asturnando/generador/assets/img/cap4-bobinado-manual-referencia-generada.webp

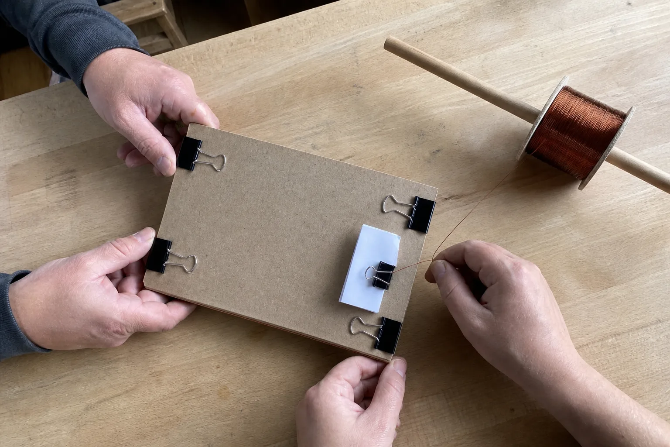
assets/img/cap4-bobinado-manual-referencia-generada.webp
