asturnando/generador/assets/img/cap4-bobina-manual-aceptable-referencia-generada.webp

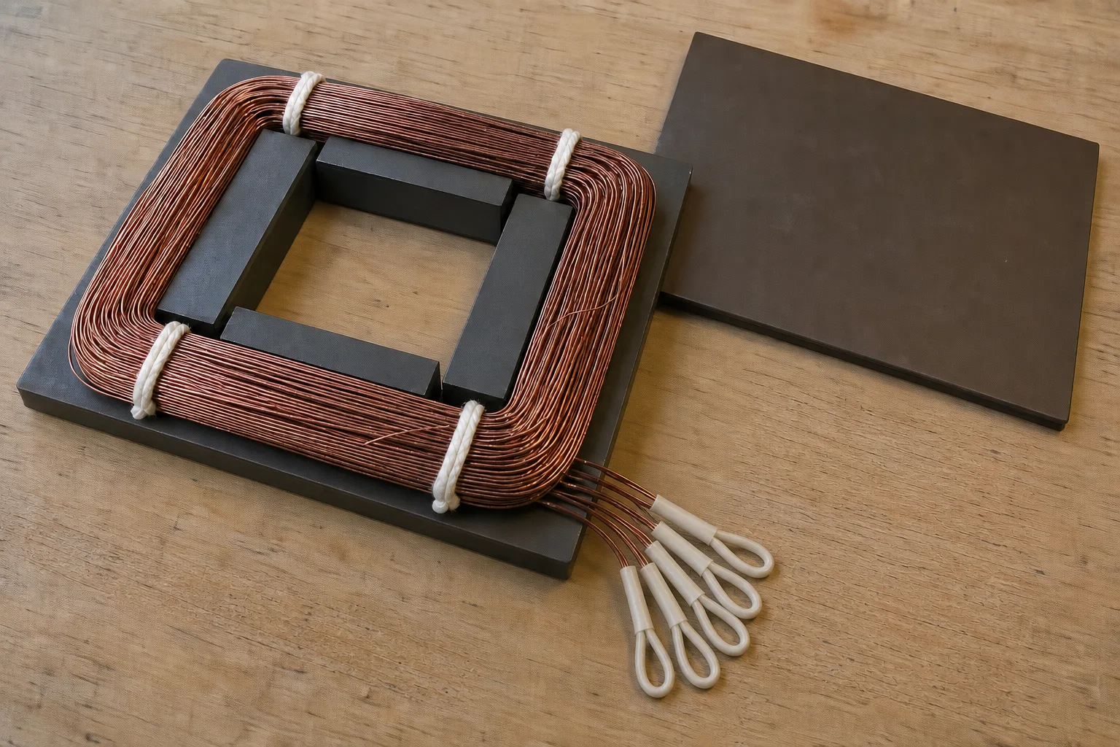
assets/img/cap4-bobina-manual-aceptable-referencia-generada.webp
