asturnando/generador/assets/img/adaptador-eje-motor.webp

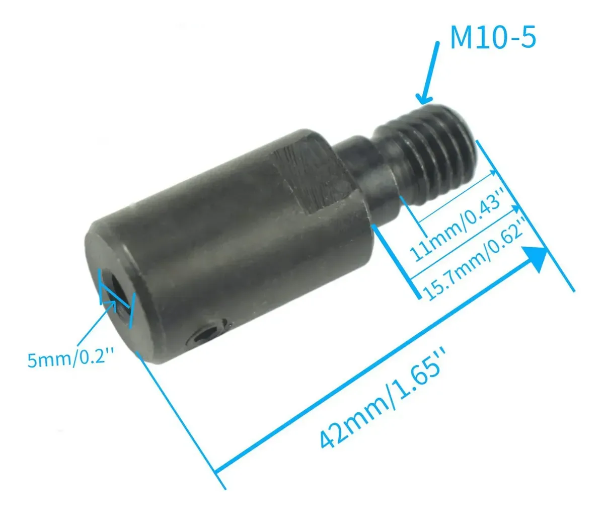
assets/img/adaptador-eje-motor.webp
