asturnando/generador/assets/img/alargador-con-tierra.webp

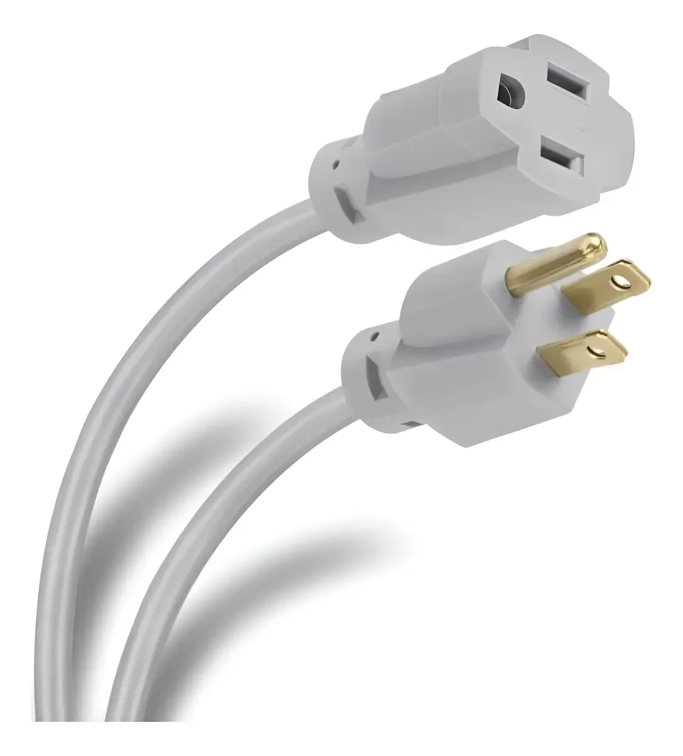
assets/img/alargador-con-tierra.webp
