asturnando/generador/assets/img/cable-awg18.webp

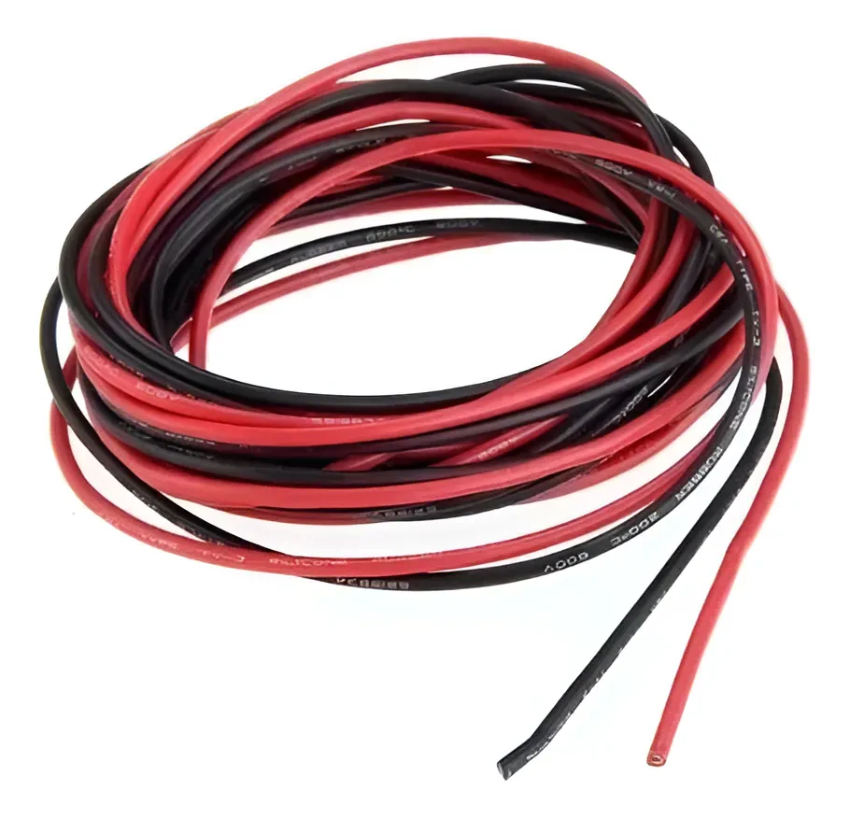
assets/img/cable-awg18.webp
