asturnando/generador/assets/img/cables-dupont-referencia-generada.webp

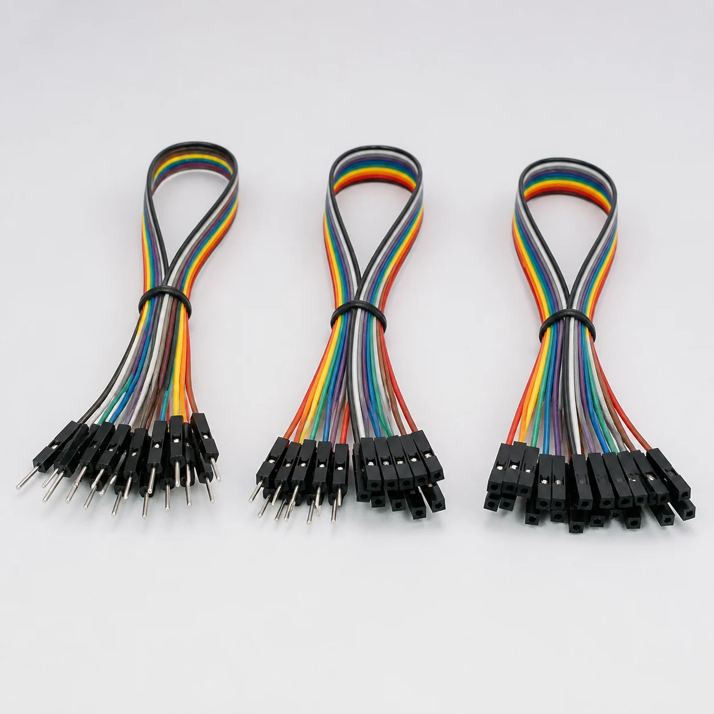
assets/img/cables-dupont-referencia-generada.webp
