asturnando/generador/assets/img/cap1-conductores-sin-pelar-referencia-generada.webp

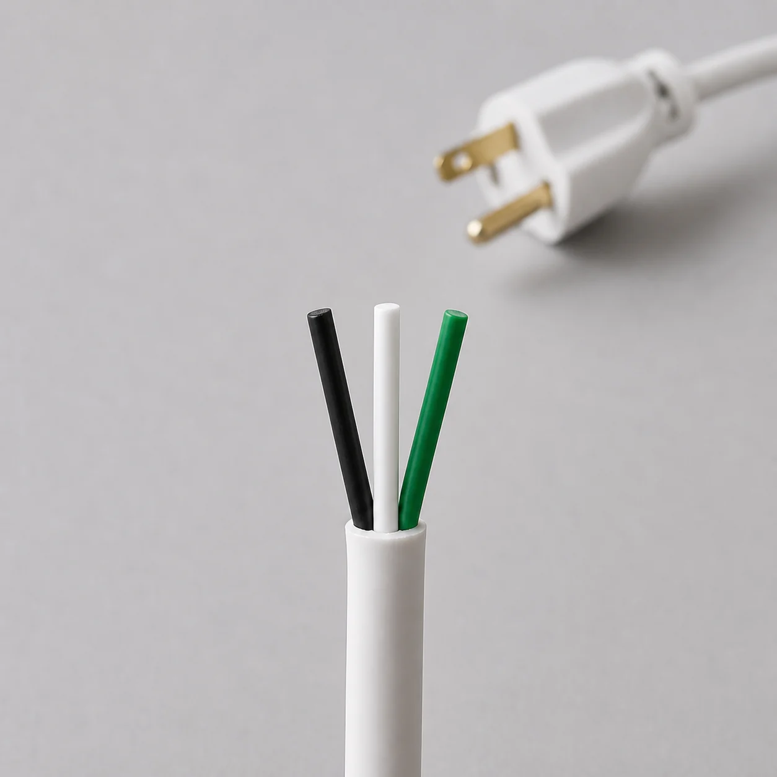
assets/img/cap1-conductores-sin-pelar-referencia-generada.webp
