asturnando/generador/assets/img/cap1-mesa-trabajo-referencia-generada.webp

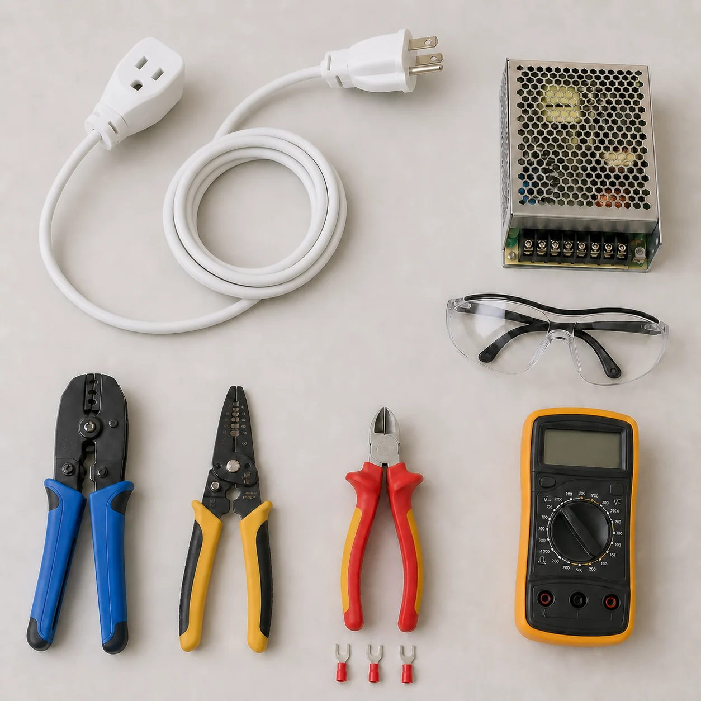
assets/img/cap1-mesa-trabajo-referencia-generada.webp
