asturnando/generador/assets/img/cap1-proteccion-fuente-referencia-generada.webp

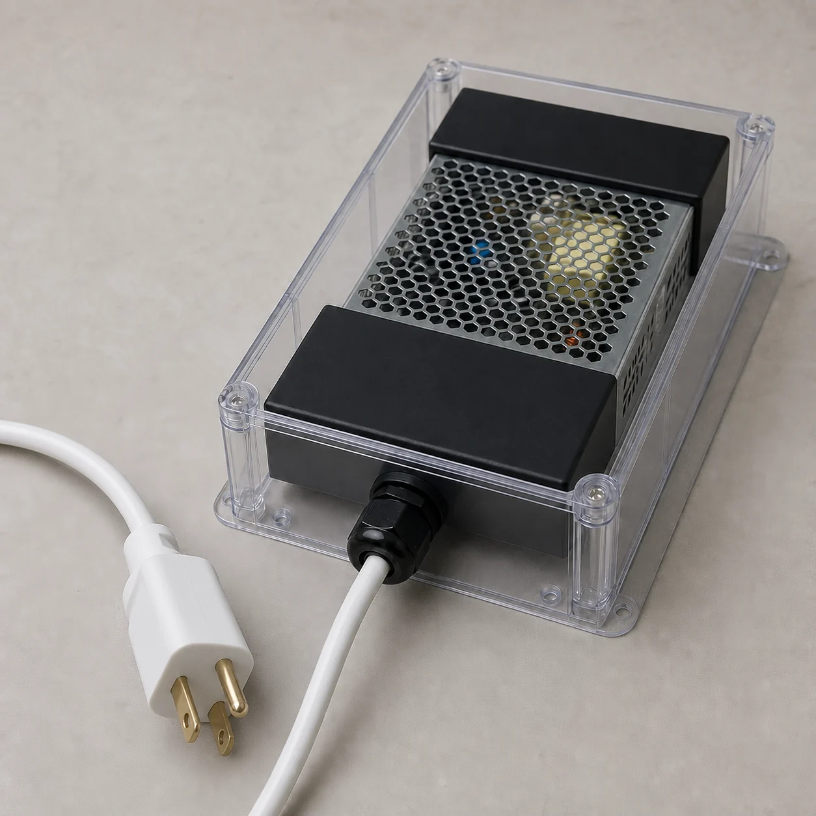
assets/img/cap1-proteccion-fuente-referencia-generada.webp
