asturnando/generador/assets/img/cap1-terminales-crimpados-referencia-generada.webp

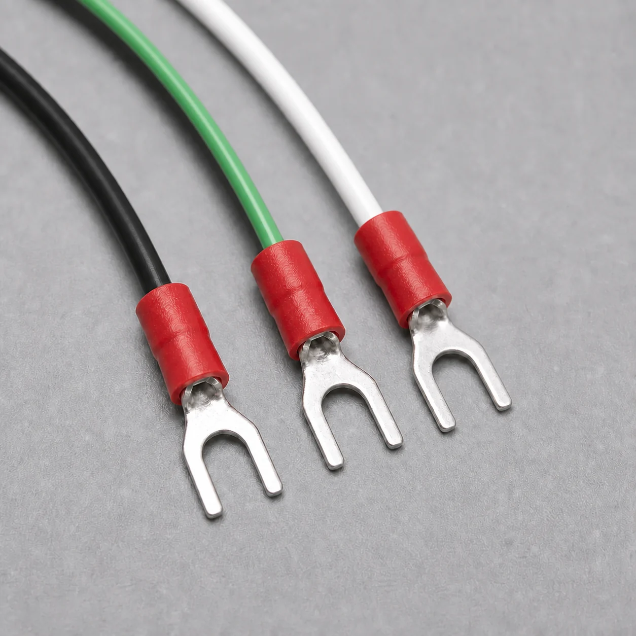
assets/img/cap1-terminales-crimpados-referencia-generada.webp
