asturnando/generador/assets/img/cap2-banco-sin-cablear-referencia-generada.webp

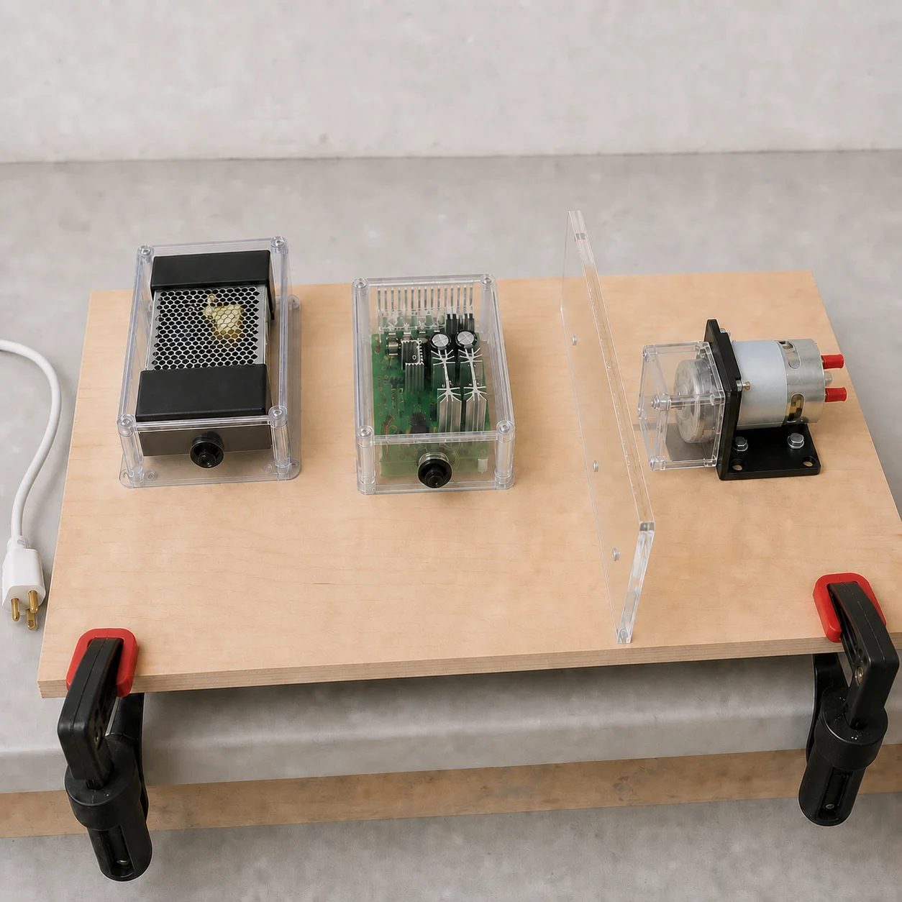
assets/img/cap2-banco-sin-cablear-referencia-generada.webp
