asturnando/generador/assets/img/cap2-motor-sujeto-referencia-generada.webp

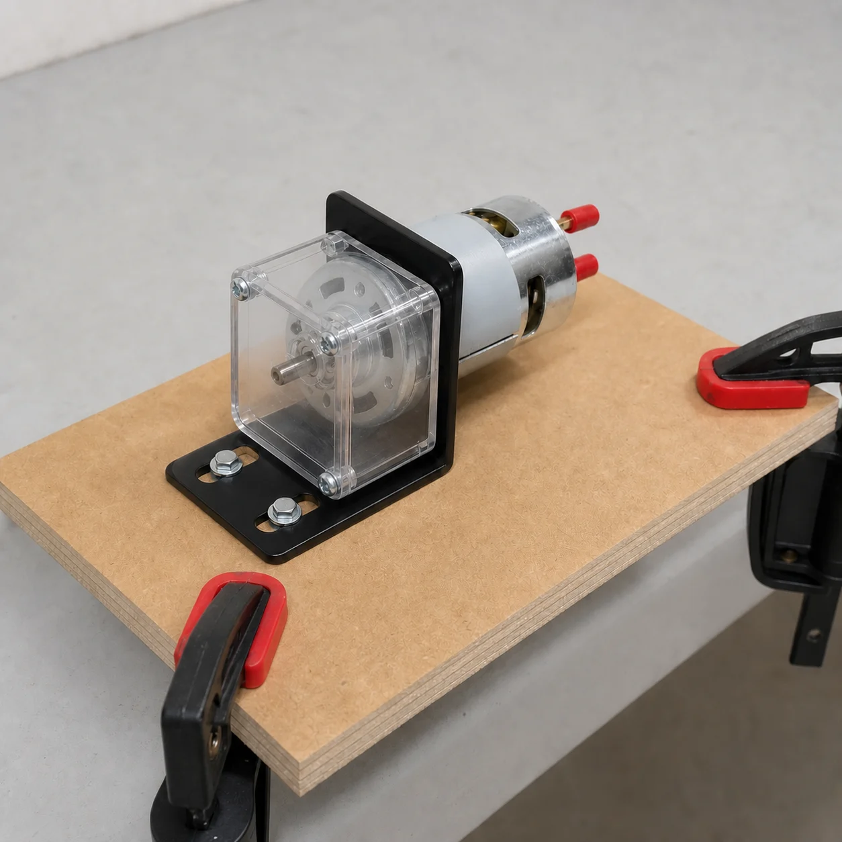
assets/img/cap2-motor-sujeto-referencia-generada.webp
