asturnando/generador/assets/img/cap2-pwm-protegido-referencia-generada.webp

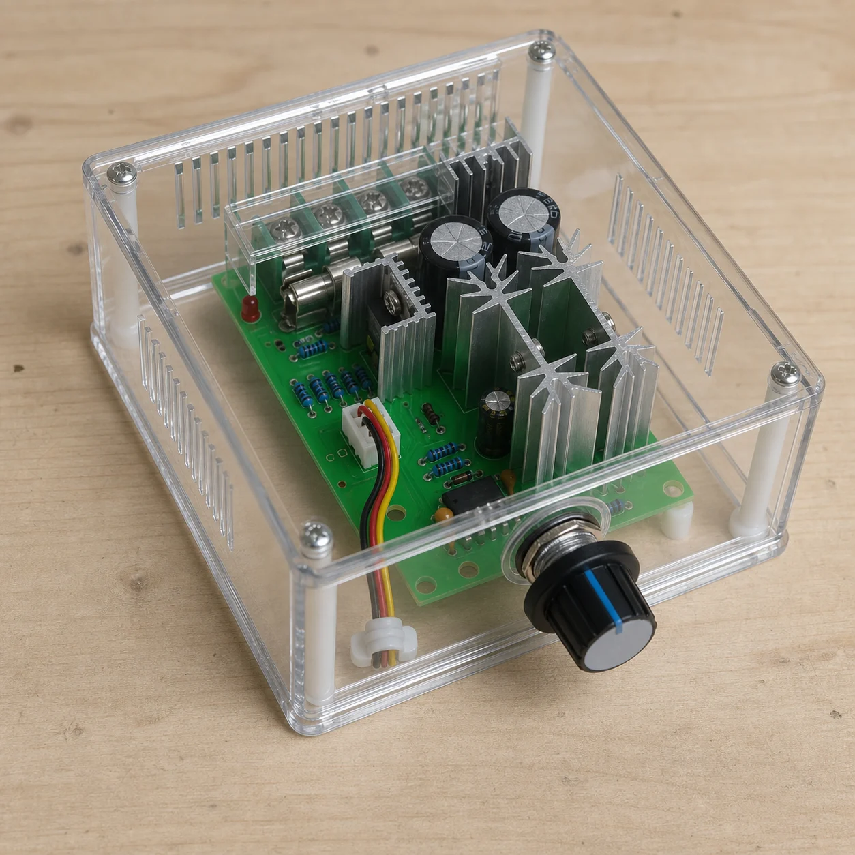
assets/img/cap2-pwm-protegido-referencia-generada.webp
