asturnando/generador/assets/img/cap3-clasificacion-imanes-referencia-generada.webp

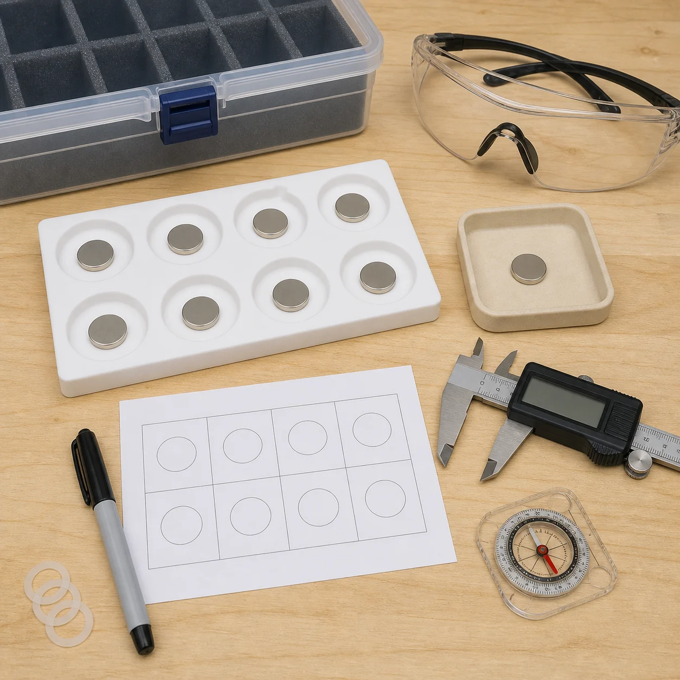
assets/img/cap3-clasificacion-imanes-referencia-generada.webp
