asturnando/generador/assets/img/cap3-medicion-adaptador-referencia-generada.webp

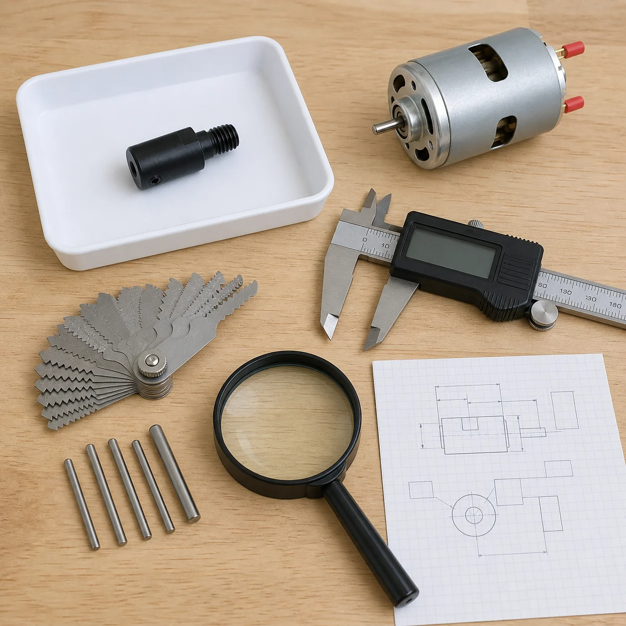
assets/img/cap3-medicion-adaptador-referencia-generada.webp
