asturnando/generador/assets/img/cap4-bobina-final-referencia-generada.webp

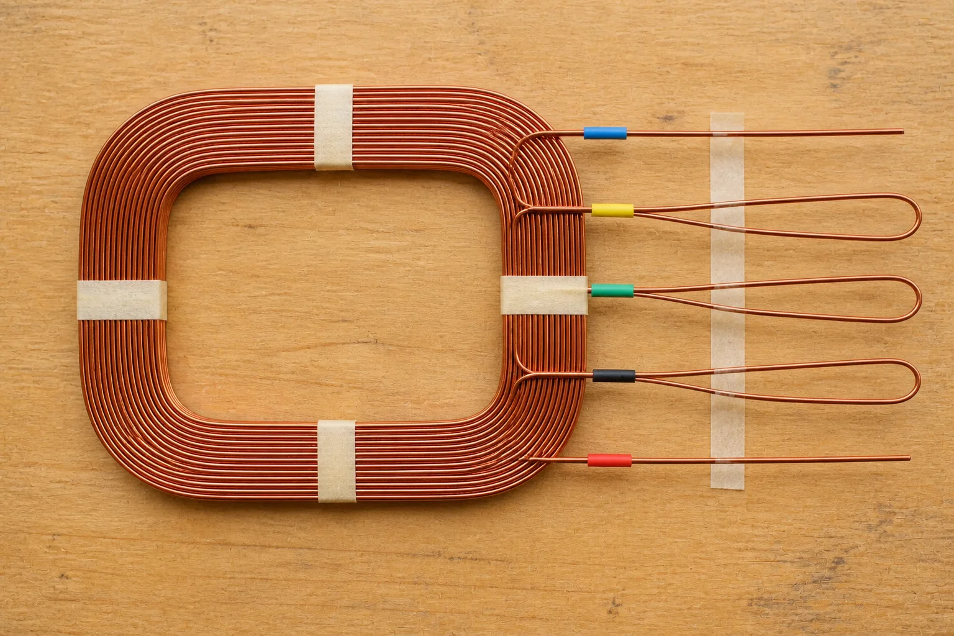
assets/img/cap4-bobina-final-referencia-generada.webp
