asturnando/generador/assets/img/cap4-derivacion-u-referencia-generada.webp

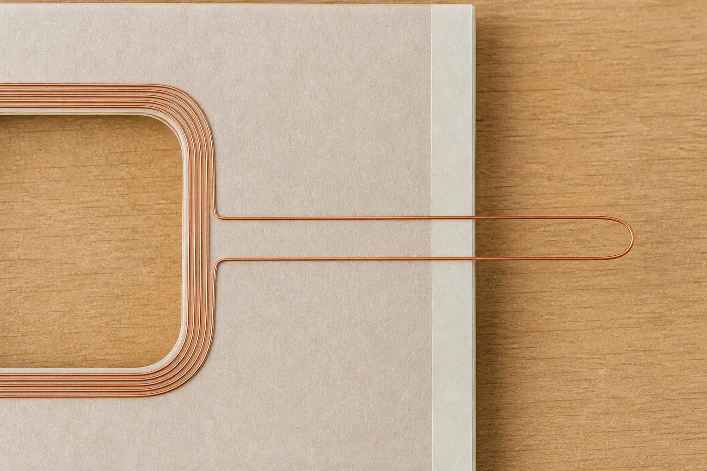
assets/img/cap4-derivacion-u-referencia-generada.webp
