asturnando/generador/assets/img/cap4-inicio-bobinado-referencia-generada.webp

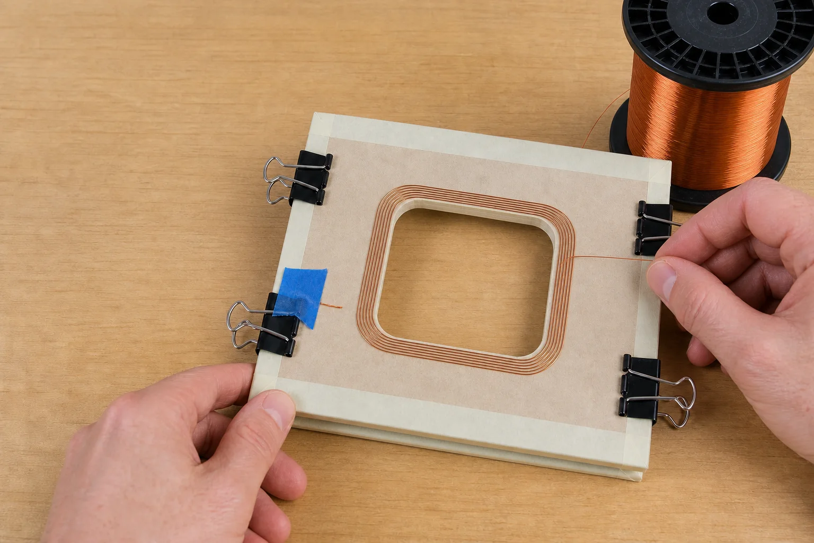
assets/img/cap4-inicio-bobinado-referencia-generada.webp
