asturnando/generador/assets/img/cap4-multimetro-continuidad-referencia-generada.webp

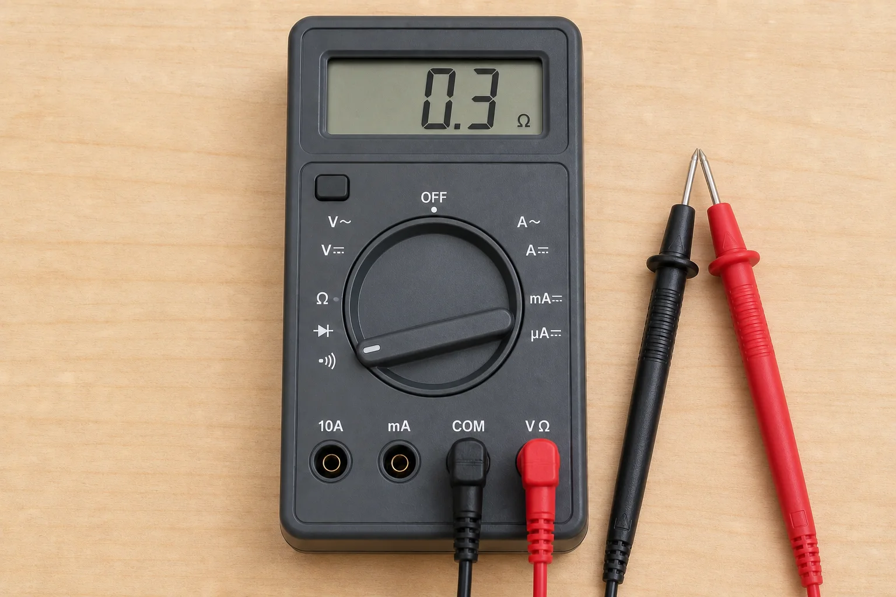
assets/img/cap4-multimetro-continuidad-referencia-generada.webp
