asturnando/generador/assets/img/cap4-multimetro-puntas-referencia-generada.webp

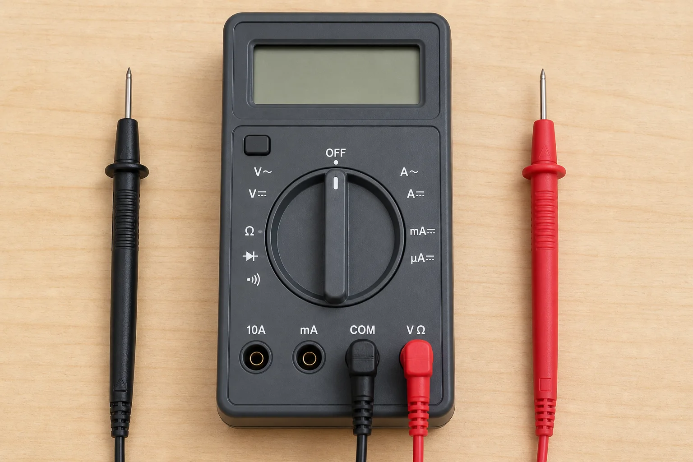
assets/img/cap4-multimetro-puntas-referencia-generada.webp
