asturnando/generador/assets/img/cap4-multimetro-resistencia-referencia-generada.webp

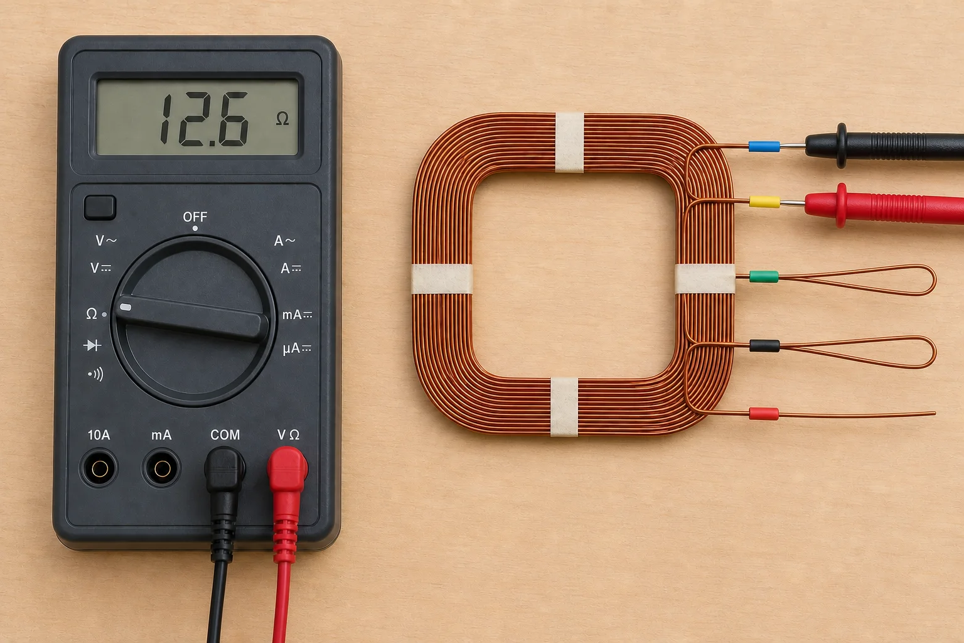
assets/img/cap4-multimetro-resistencia-referencia-generada.webp
