asturnando/generador/assets/img/cap4-multimetro-tension-ac-referencia-generada.webp

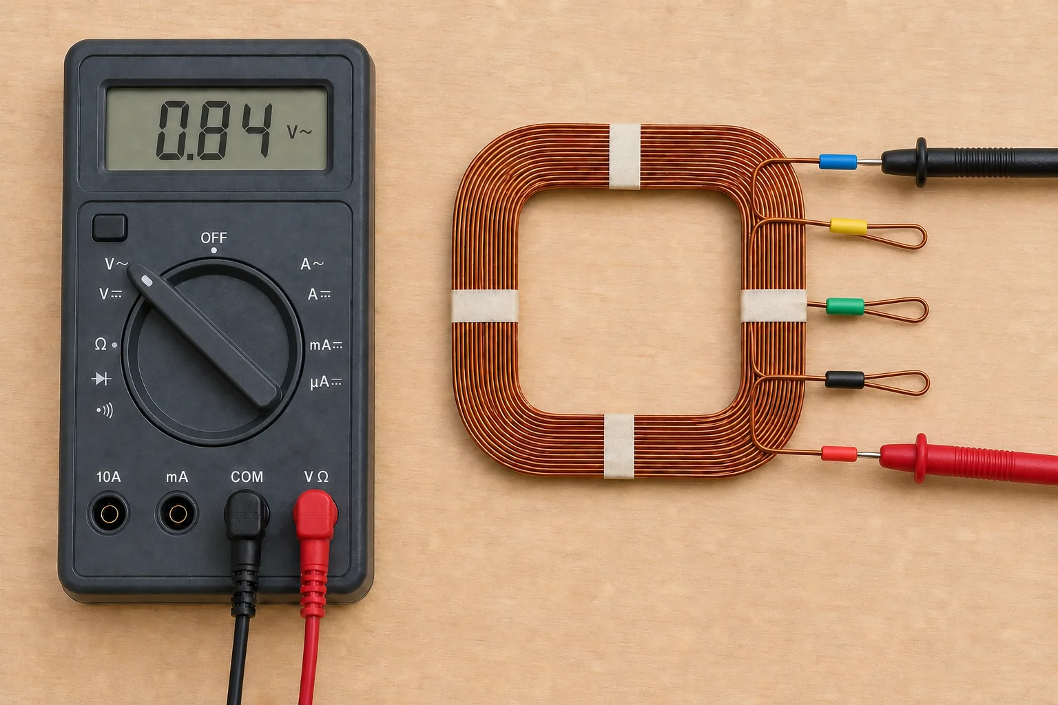
assets/img/cap4-multimetro-tension-ac-referencia-generada.webp
