asturnando/generador/assets/img/cap4-soporte-bobina-ajustable-referencia-generada.webp

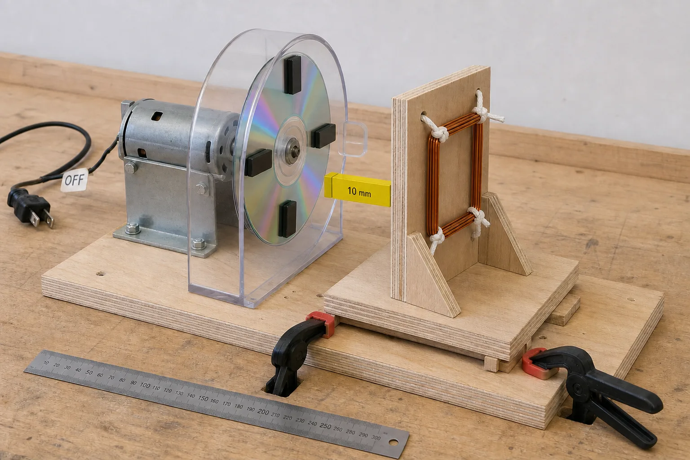
assets/img/cap4-soporte-bobina-ajustable-referencia-generada.webp
