asturnando/generador/assets/img/cap4-util-bobinado-referencia-generada.webp

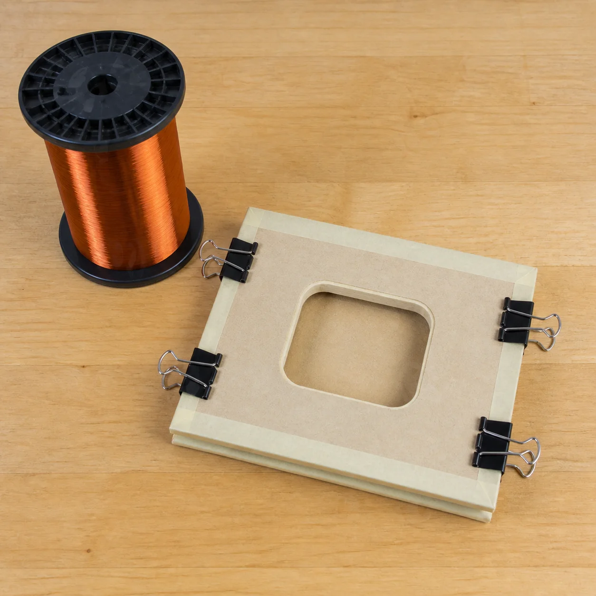
assets/img/cap4-util-bobinado-referencia-generada.webp
