asturnando/generador/assets/img/cap4-util-cerrado-referencia-generada.webp

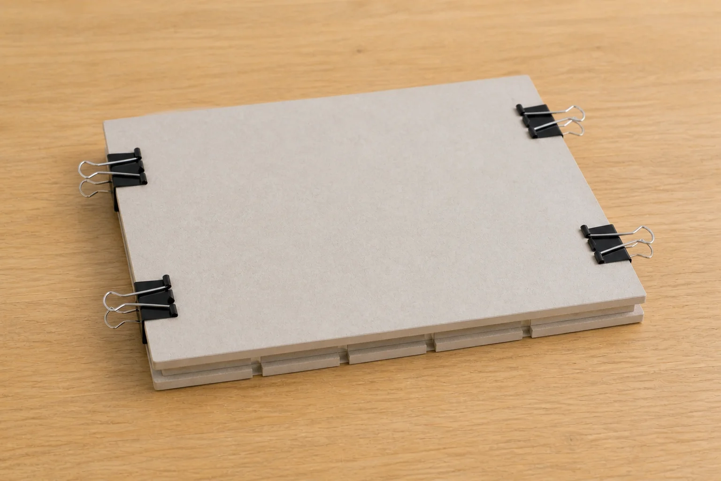
assets/img/cap4-util-cerrado-referencia-generada.webp
