asturnando/generador/assets/img/cap4-util-extraccion-referencia-generada.webp

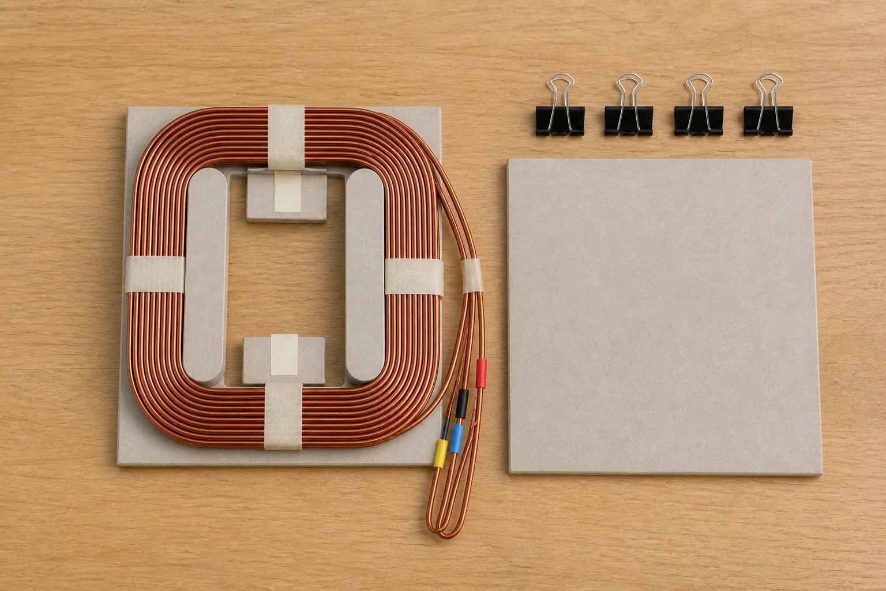
assets/img/cap4-util-extraccion-referencia-generada.webp
