asturnando/generador/assets/img/cap4-util-nucleo-referencia-generada.webp

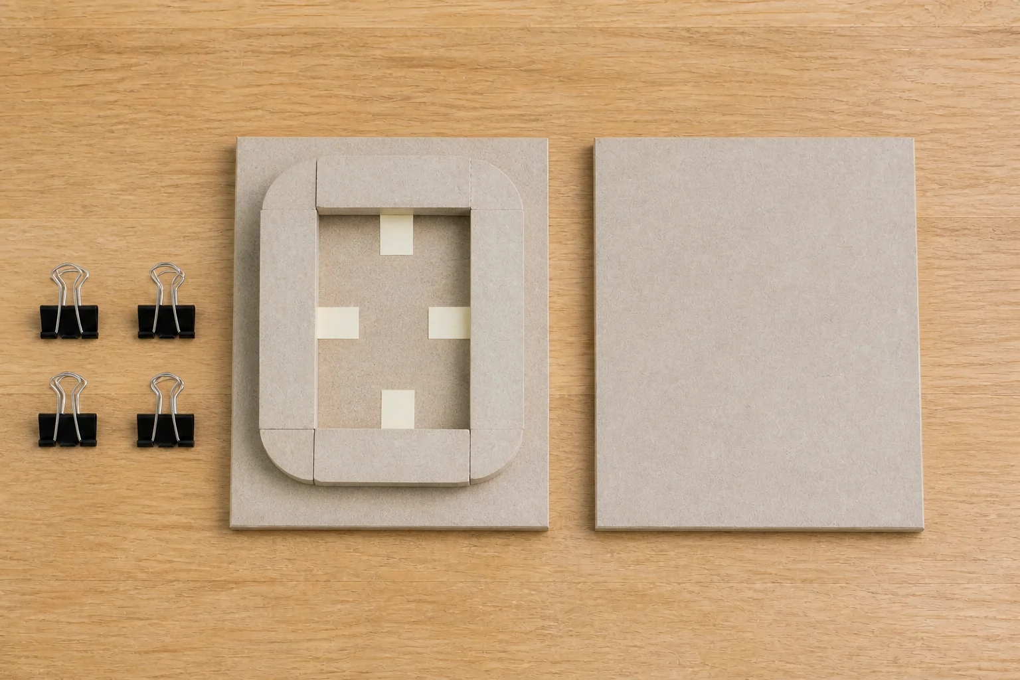
assets/img/cap4-util-nucleo-referencia-generada.webp
