asturnando/generador/assets/img/cap4-util-piezas-referencia-generada.webp

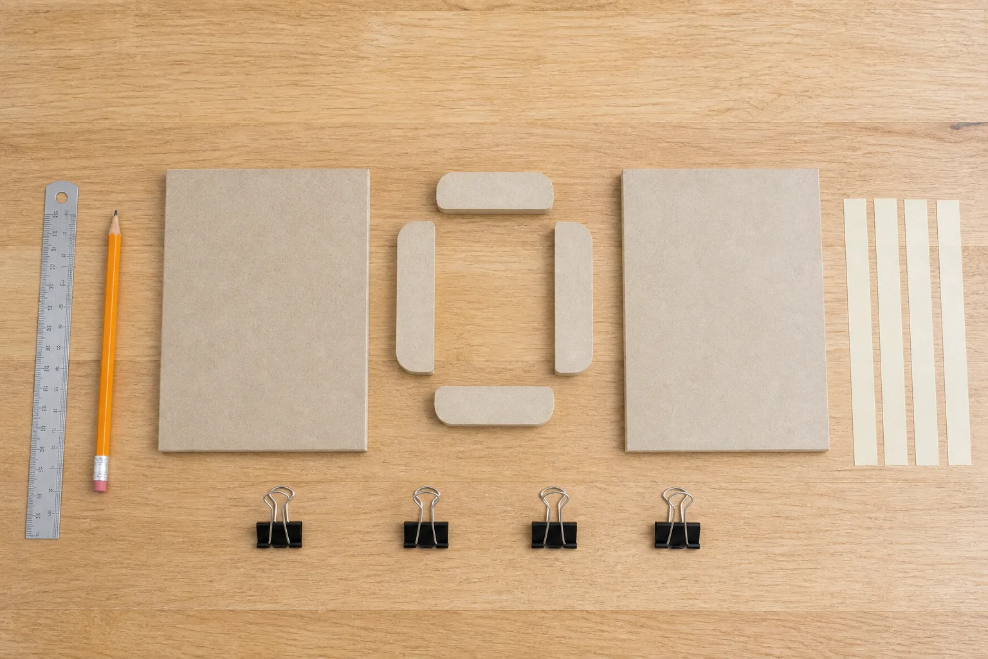
assets/img/cap4-util-piezas-referencia-generada.webp
