asturnando/generador/assets/img/cobre-esmaltado-awg28.webp

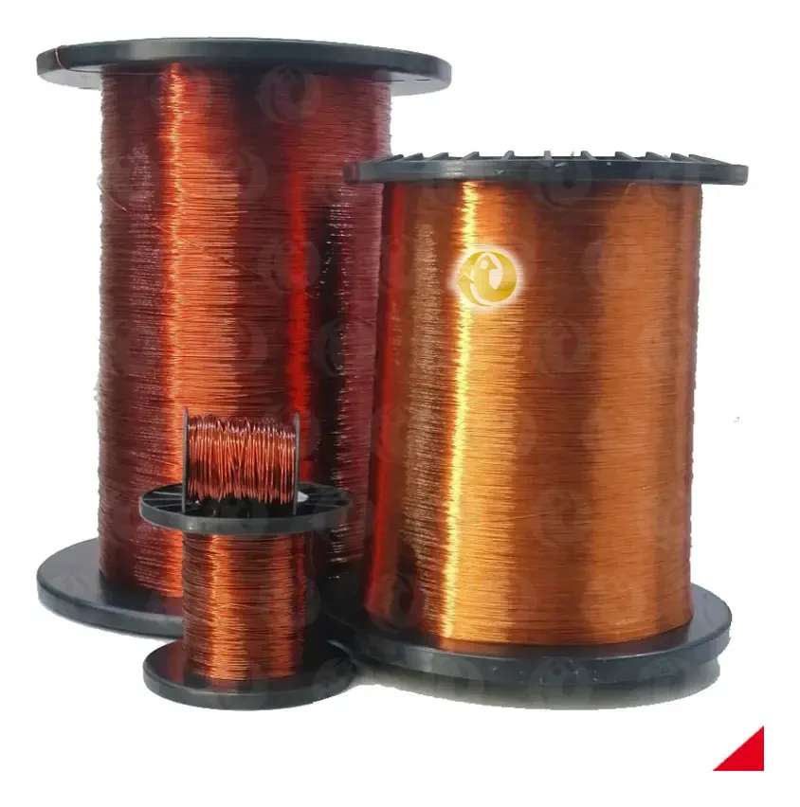
assets/img/cobre-esmaltado-awg28.webp
