asturnando/generador/assets/img/diodos-1n5818.webp

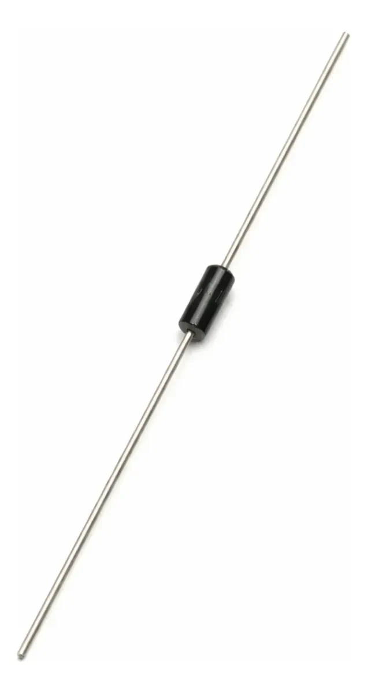
assets/img/diodos-1n5818.webp
