asturnando/generador/assets/img/disco-incluido-no-usar.webp

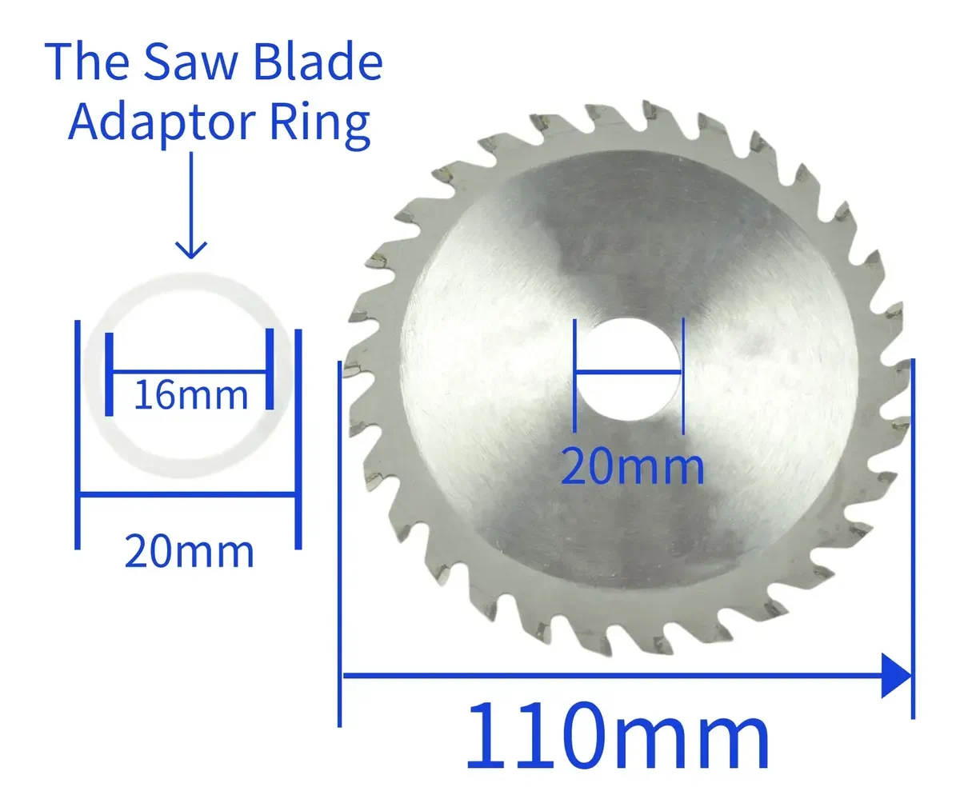
assets/img/disco-incluido-no-usar.webp
