asturnando/generador/assets/img/esp32-s3-devkitc-1-oficial.webp

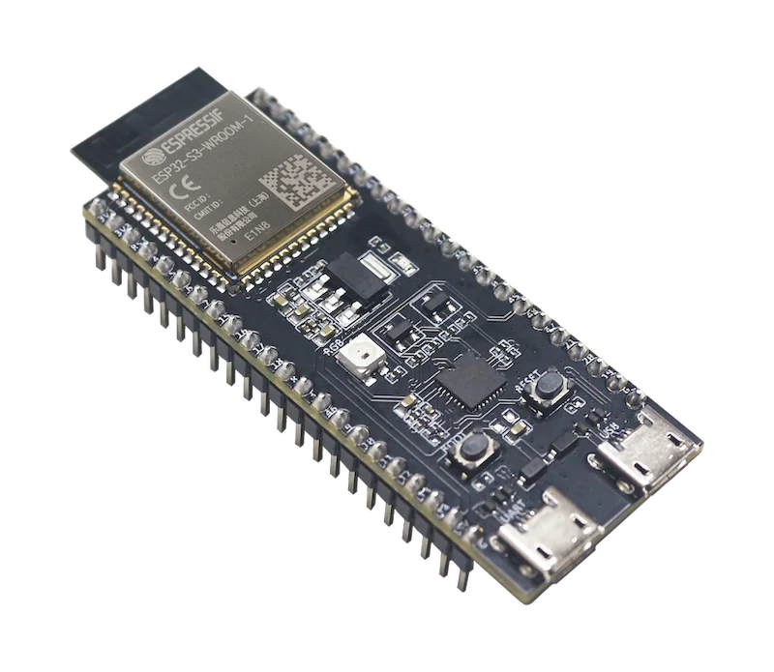
assets/img/esp32-s3-devkitc-1-oficial.webp
