asturnando/generador/assets/img/fuente-12v-10a-vista.webp

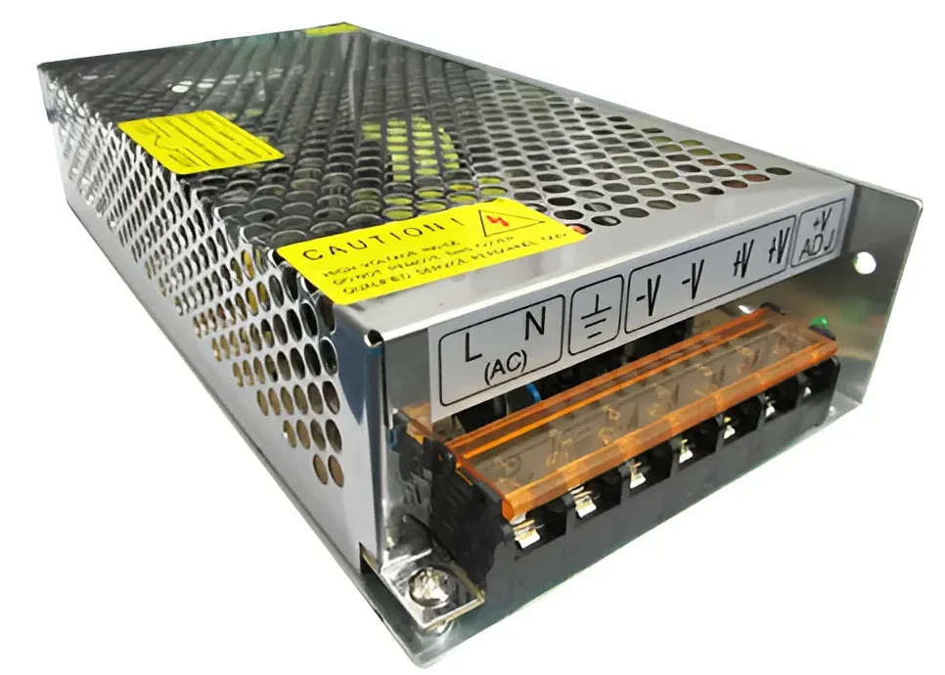
assets/img/fuente-12v-10a-vista.webp
