asturnando/generador/assets/img/fuente-12v-10a.webp

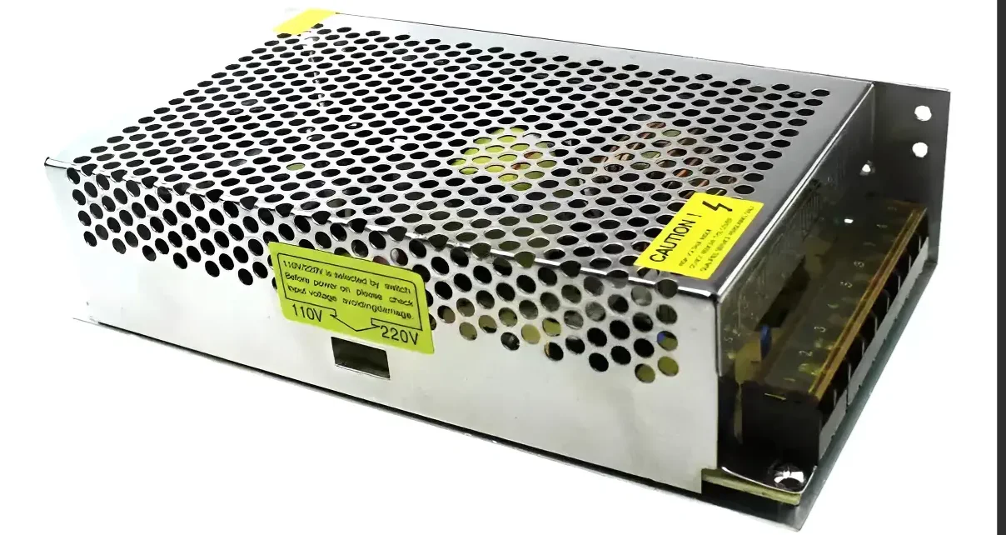
assets/img/fuente-12v-10a.webp
