asturnando/generador/assets/img/fuente-bornes.webp

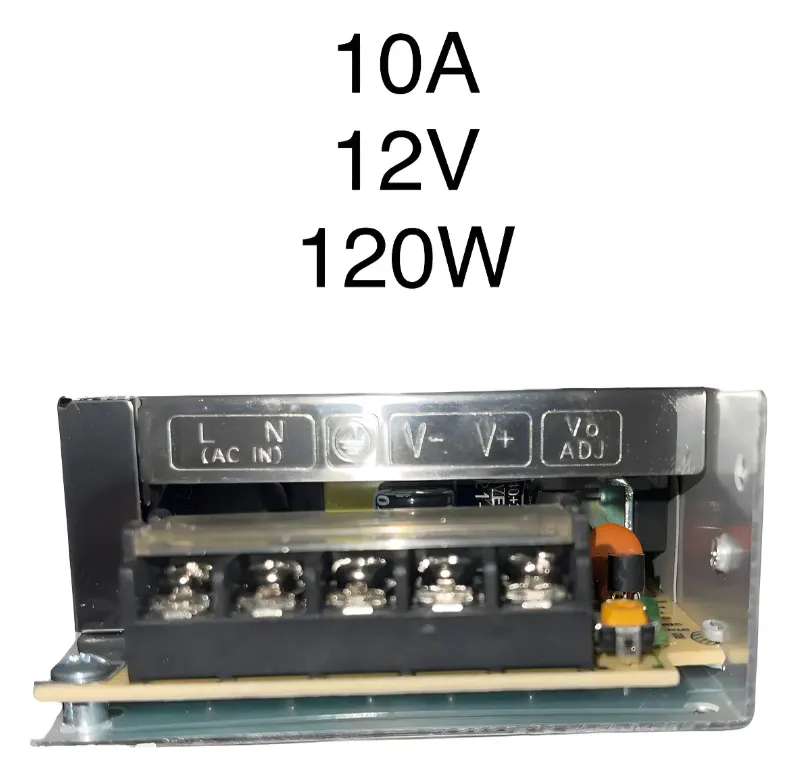
assets/img/fuente-bornes.webp
