asturnando/generador/assets/img/fuente-selector-tension.webp

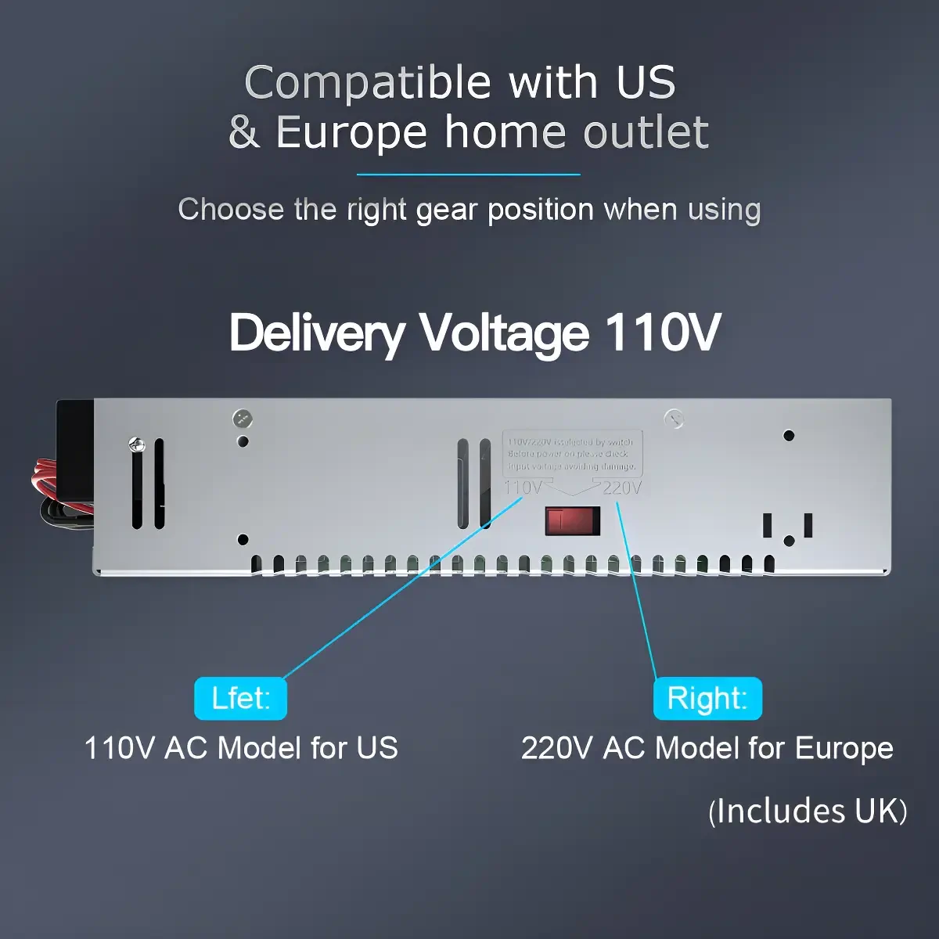
assets/img/fuente-selector-tension.webp
