asturnando/generador/assets/img/imanes-rectangulares.webp

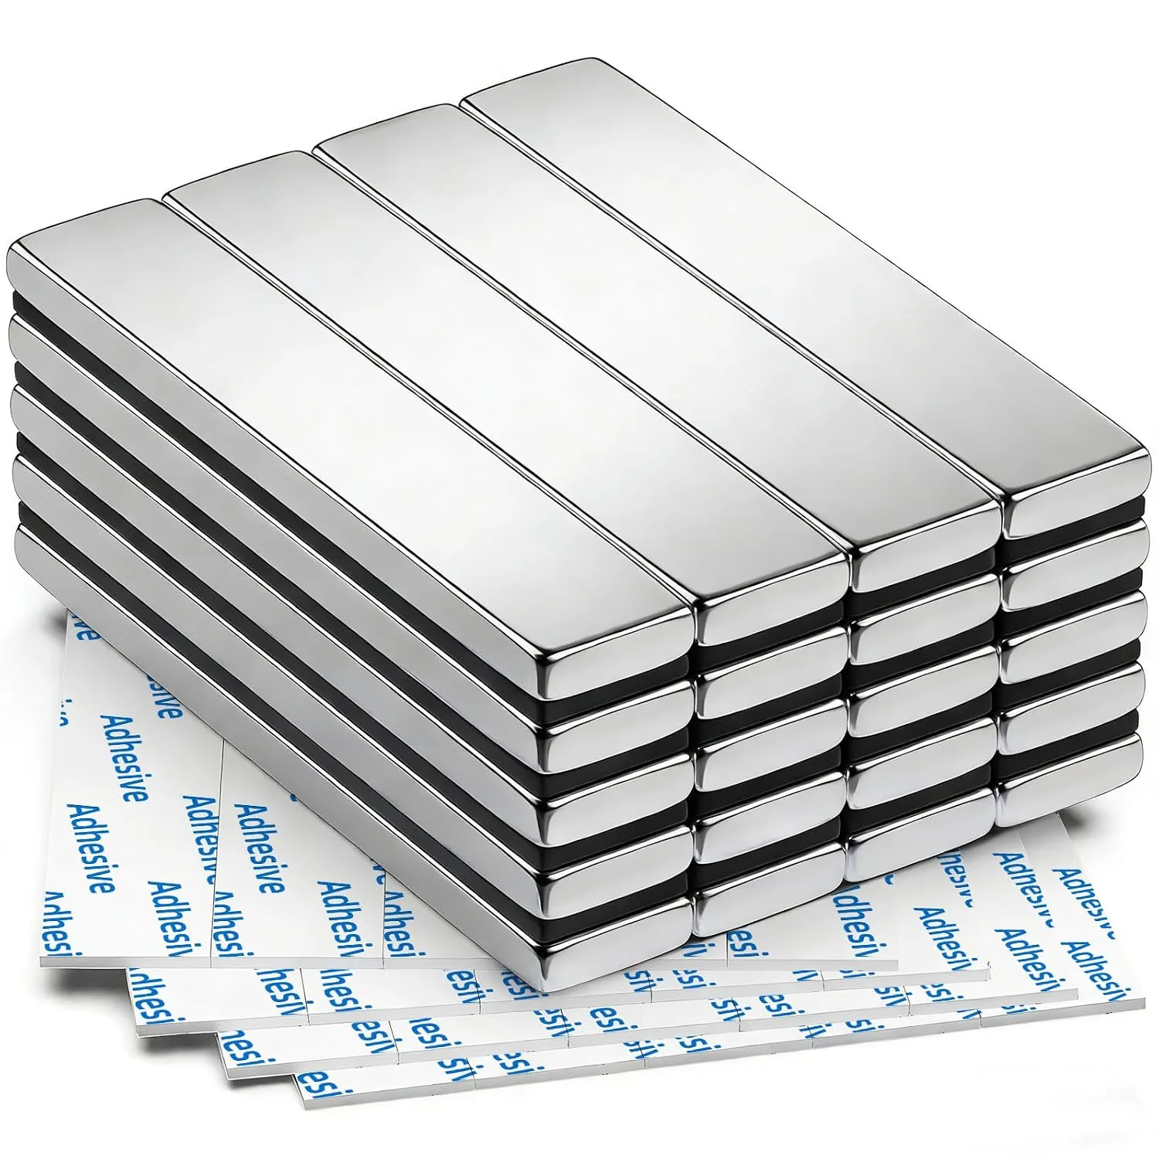
assets/img/imanes-rectangulares.webp
