asturnando/generador/assets/img/imanes-redondos-referencia-generada.webp

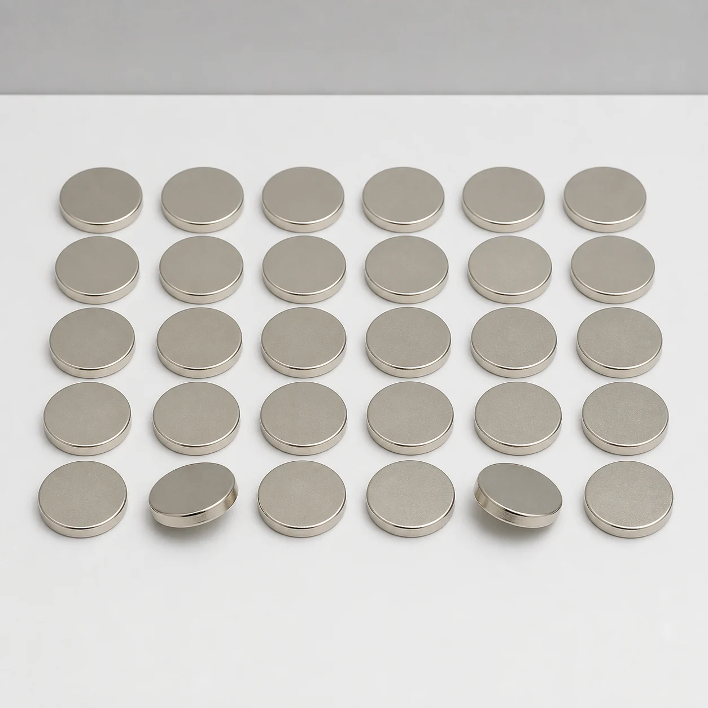
assets/img/imanes-redondos-referencia-generada.webp
