asturnando/generador/assets/img/ina219.webp

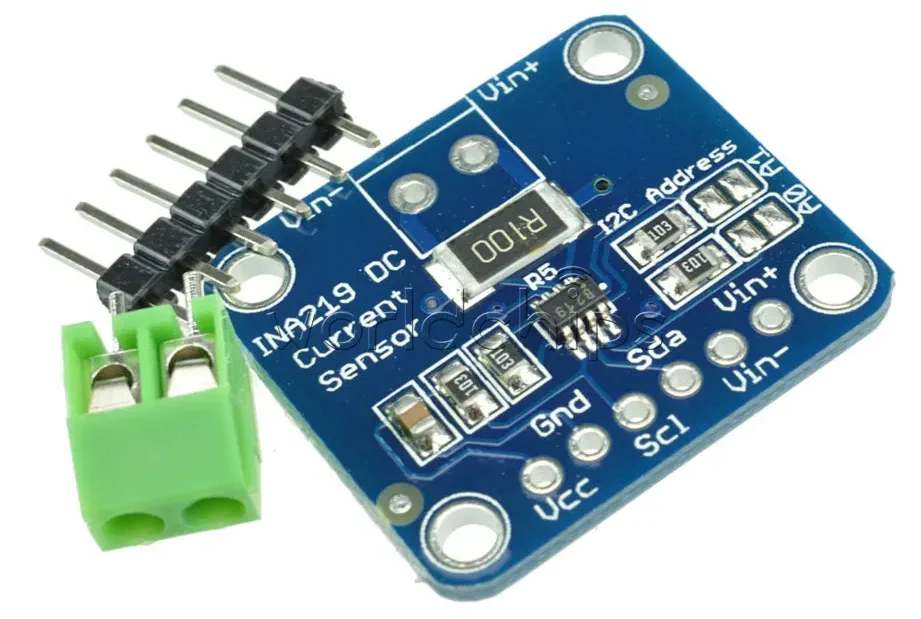
assets/img/ina219.webp
