asturnando/generador/assets/img/kit-resistencias-referencia-generada.webp

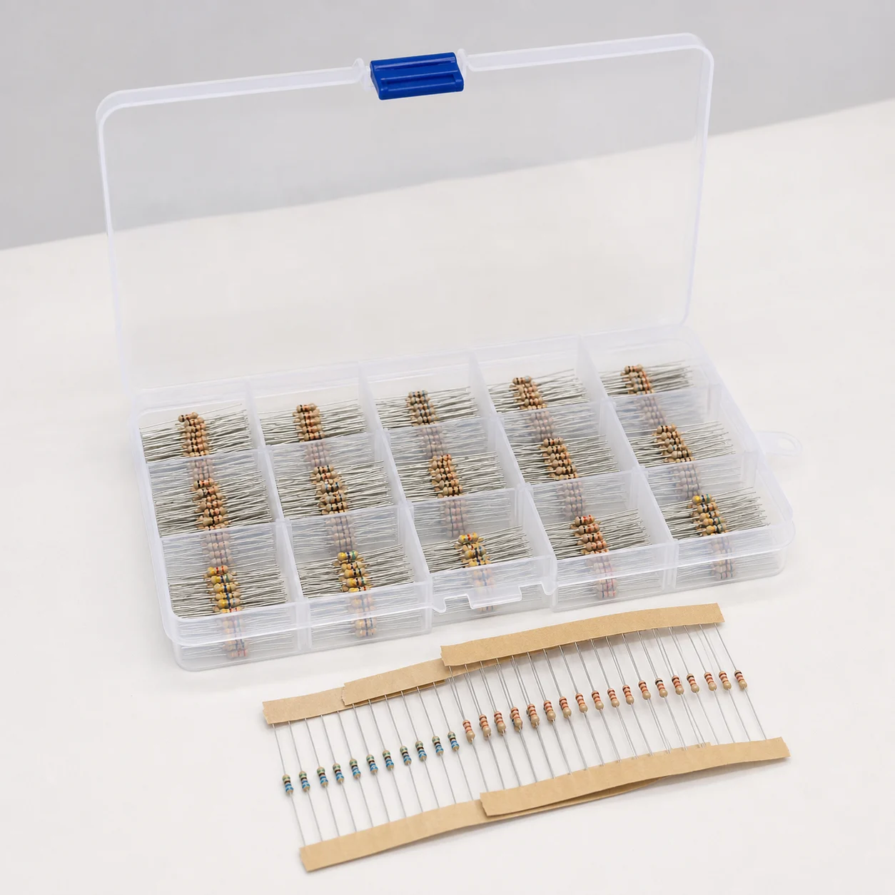
assets/img/kit-resistencias-referencia-generada.webp
