asturnando/generador/assets/img/ky003.webp

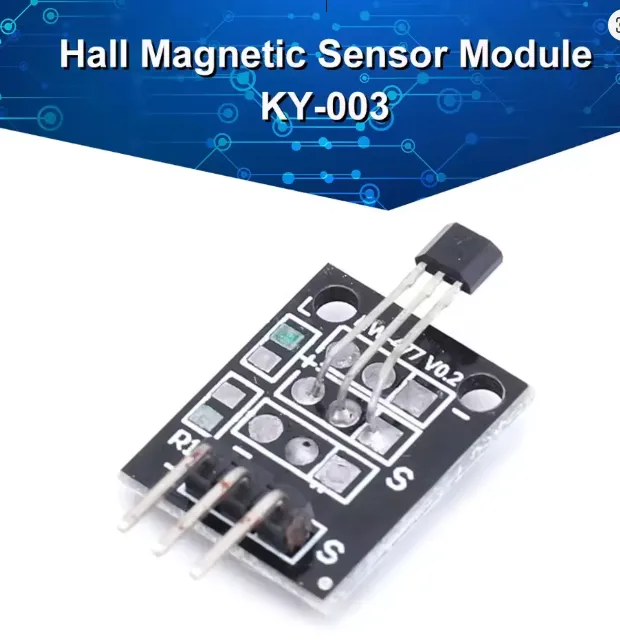
assets/img/ky003.webp
