asturnando/generador/assets/img/leds-referencia-generada.webp

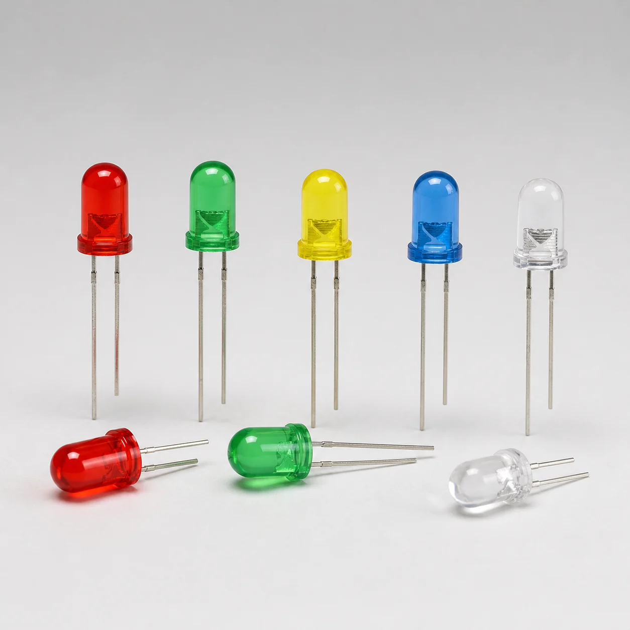
assets/img/leds-referencia-generada.webp
