asturnando/generador/assets/img/motor-775-kit.webp

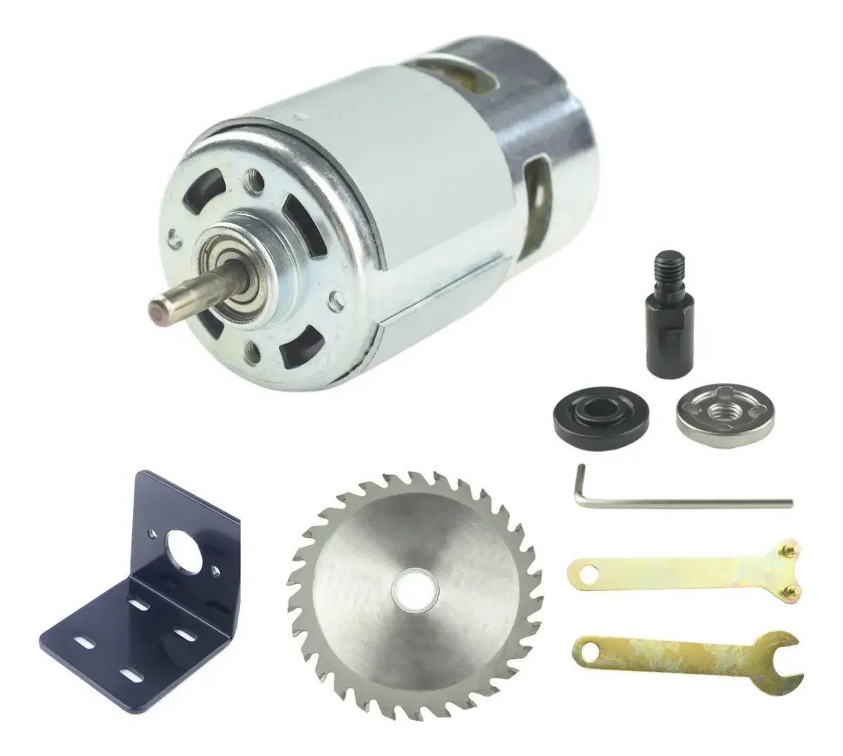
assets/img/motor-775-kit.webp
