asturnando/generador/assets/img/motor-775-medidas.webp

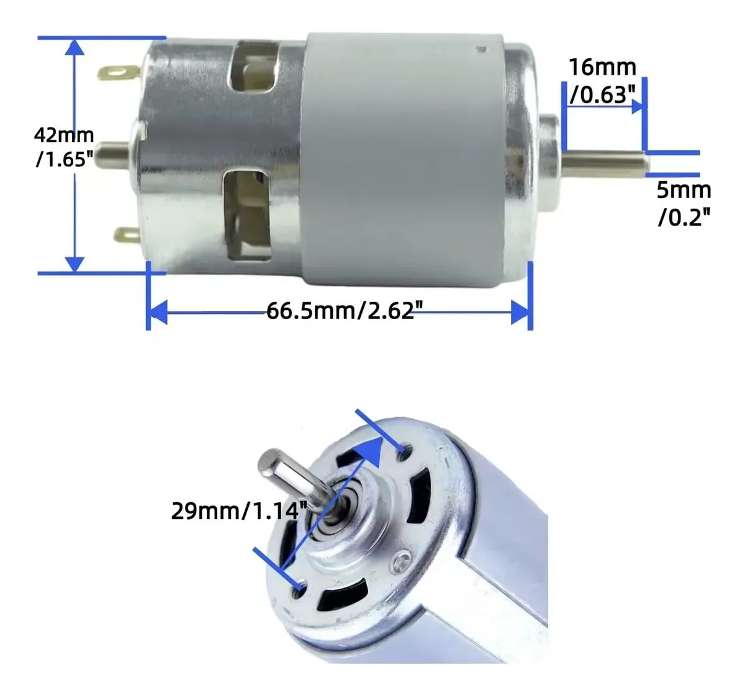
assets/img/motor-775-medidas.webp
