asturnando/generador/assets/img/protoboard.webp

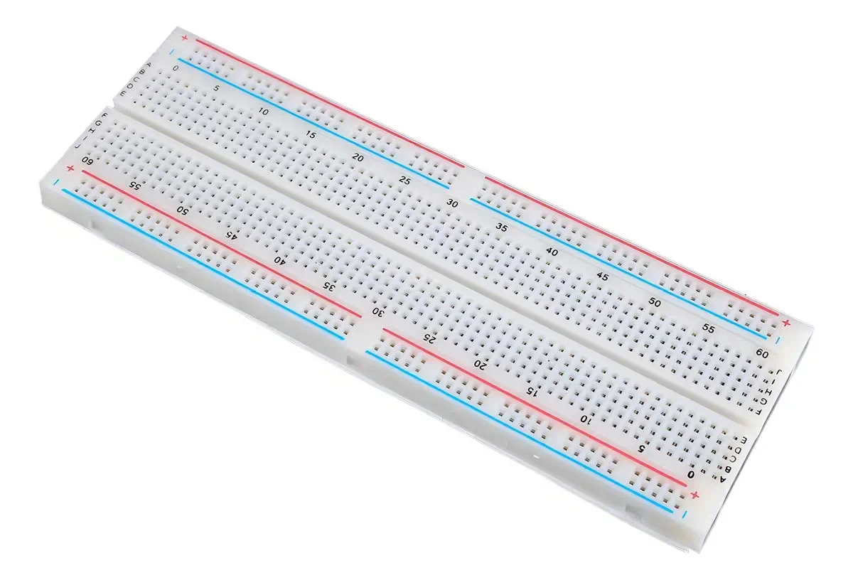
assets/img/protoboard.webp
