asturnando/generador/assets/img/pwm-vista.webp

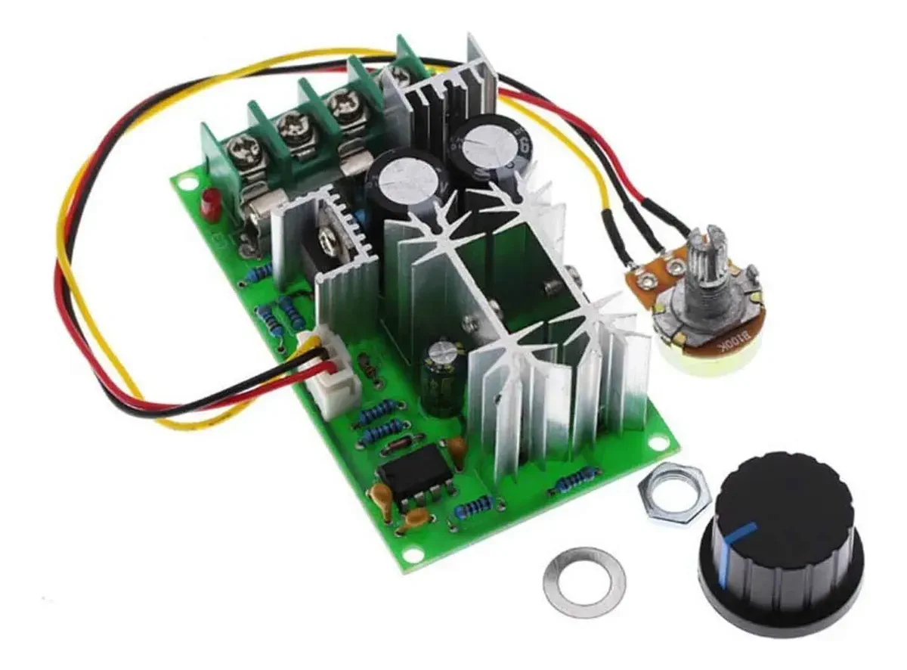
assets/img/pwm-vista.webp
