asturnando/generador/assets/img/pwm.webp

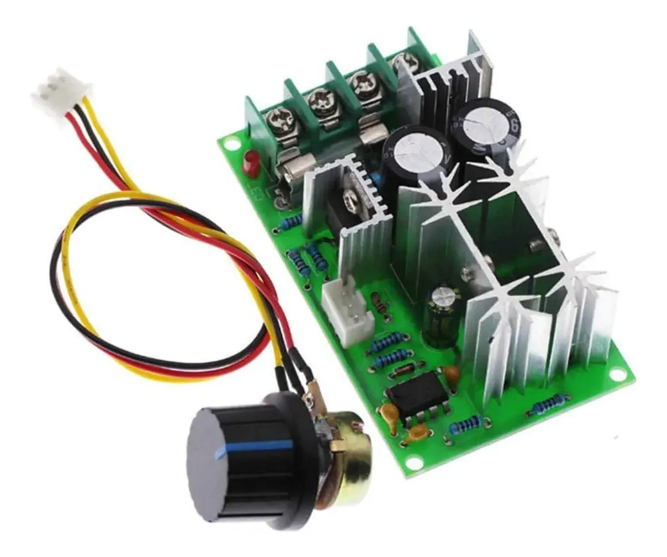
assets/img/pwm.webp
