asturnando/generador/assets/img/resistencia-100ohm-5w.webp

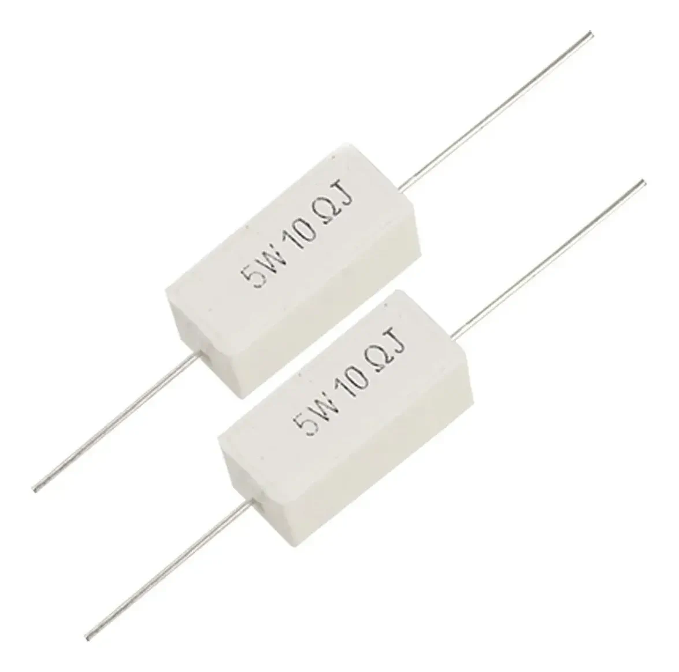
assets/img/resistencia-100ohm-5w.webp
