asturnando/generador/assets/img/soporte-motor-775.webp

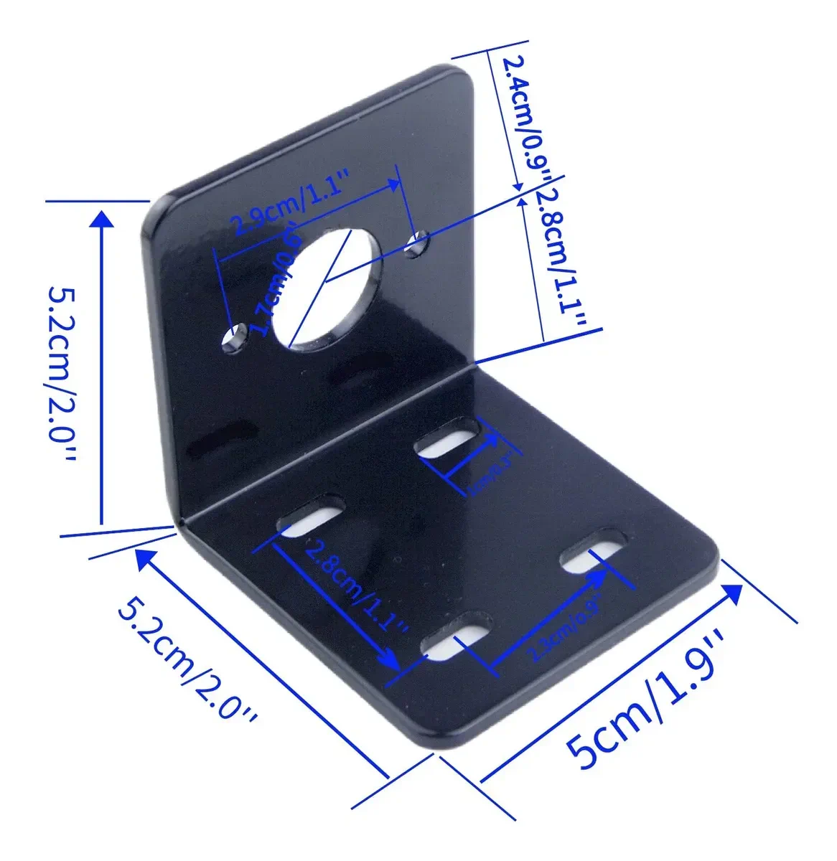
assets/img/soporte-motor-775.webp
