asturnando/generador/assets/img/tcrt5000.webp

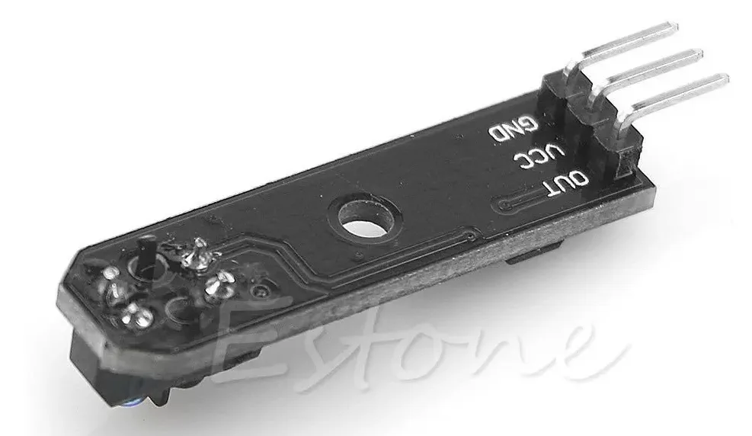
assets/img/tcrt5000.webp
