asturnando/generador/assets/img/terminales-horquilla.webp

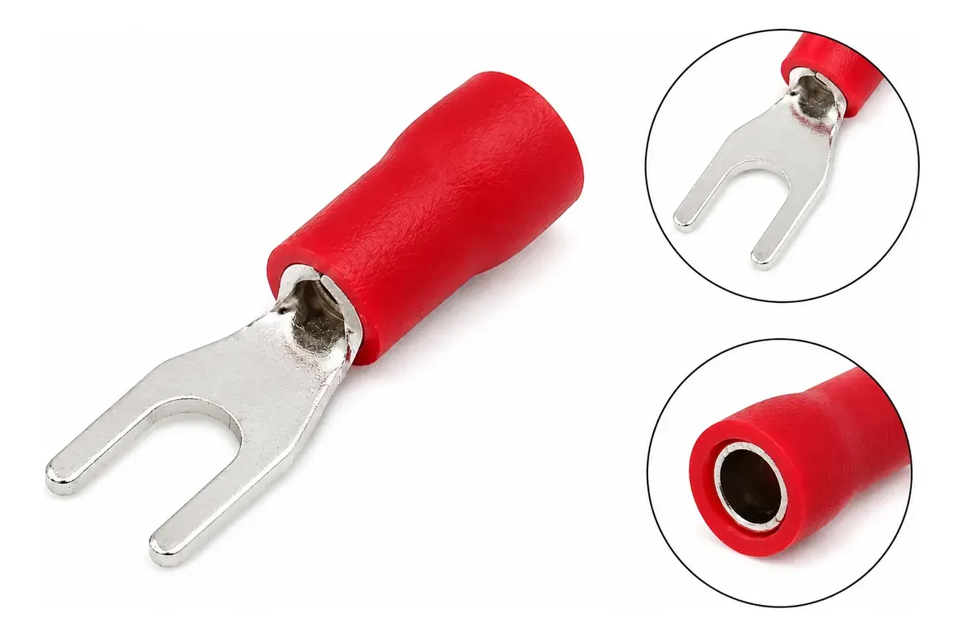
assets/img/terminales-horquilla.webp
