asturnando/generador/assets/js/consola.js

import { parseSerialLine, commandText, hex } from './monitor-protocol.js?v=5';
// =============================================================================
// consola.js · Lógica de la Consola USB (consola.html)
// =============================================================================
//
// Qué hace:
//   - Abre el puerto serie USB de la ESP32 desde el navegador (Web Serial,
//     solo Chrome/Edge de ordenador), a 115200 baudios.
//   - Lee las líneas que escribe el firmware 1.1.1: "DIAG ..." (estado de los
//     sensores) y "LECTURA ..." (RPM, voltios, modo), y las muestra en grande.
//   - Envía por el mismo cable las órdenes de siempre ("PPR:2", "SRC:IR"...),
//     que la placa contesta con "OK ..." o "ERR ...".
//
// Sirve para comprobar el montaje desde un ordenador (también por AnyDesk)
// sin depender del móvil. El Bluetooth sigue funcionando a la vez.
//
// La línea "import" de arriba debe seguir siendo la primera: las pruebas
// automáticas la quitan para ejecutar este archivo en Node.
// =============================================================================

// ---- Estado y utilidades ----
const $ = id => document.getElementById(id);
const text = (id, value) => { $(id).textContent = value; };
const message = value => text('message', value);
const format = (v, decimals) => v === null || v === undefined ? '—' : v.toLocaleString('es-CO', { minimumFractionDigits: decimals, maximumFractionDigits: decimals });
const MODES = ['DEMO', 'REAL', 'MIXED'];
const MODE_NAMES = { DEMO: 'Demostración', REAL: 'Real', MIXED: 'Mixto' };
const STATUS_NAMES = ['lectura correcta', 'configuración incompleta', 'error del INA219', 'sin pulsos', 'fuera de rango'];

//   port     → el puerto serie abierto (o null).
//   reader   → lector de los bytes que llegan; loopDone, la promesa del bucle de lectura.
//   keepReading → false cuando se pide cerrar: el bucle de lectura termina.
//   buffer   → trozo de línea que aún no ha terminado (sin Enter).
//   lastLineAt / lastDiagAt → cuándo llegó la última línea y el último DIAG.
//   oldFirmware → true si llegan lecturas con el formato de firmware anterior.
//   counts   → últimos contadores vistos, para iluminar la tarjeta al subir.
//   bytesIn / linesIn → cuánto ha llegado desde que se conectó (para el diagnóstico).
//   stale    → true mientras se está avisando de que no llegan datos.
//   uptime   → segundos que lleva encendida la placa, según su último DIAG.
let port = null, reader = null, loopDone = null, keepReading = false, buffer = '';
let lastLineAt = 0, lastDiagAt = 0, oldFirmware = false;
let bytesIn = 0, linesIn = 0, stale = false, uptime = null;
const counts = { ir: null, hall: null };
const logLines = [];
// Errores puntuales del puerto serie (se pierde algún dato, normalmente al
// reiniciar la placa) tras los que se puede seguir leyendo. Cualquier otro
// error (por ejemplo, cable desenchufado) cierra la conexión.
const RECOVERABLE = new Set(['BufferOverrunError', 'BreakError', 'FramingError', 'ParityError']);

// Activa o desactiva los botones según haya o no un puerto abierto.
function setControls() {
  const open = !!port;
  $('connect').disabled = open || !('serial' in navigator);
  for (const id of ['disconnect', 'reset', 'zero', 'sensor', 'ppr', 'save-ppr', 'mode', 'scan', 'command', 'send']) $(id).disabled = !open;
}

// Añade una línea al registro de mensajes (se guardan las 150 últimas).
function addLog(line) {
  logLines.push(line); if (logLines.length > 150) logLines.shift();
  const log = $('log'); log.textContent = logLines.join('\n');
  log.scrollTop = log.scrollHeight;  // Siempre se ve la más reciente.
}

// ---- Conexión ----

// Pide al navegador que elija un puerto, lo abre y empieza a leer.
async function connect() {
  try {
    const selected = await navigator.serial.requestPort();
    // bufferSize: memoria para lo que llega mientras la página está ocupada.
    // Con el valor por defecto (255 bytes) se pierden trozos al arrancar la
    // placa, que escribe mucho de golpe.
    await selected.open({ baudRate: 115200, bufferSize: 16384 });
    // Las líneas DTR y RTS NO se tocan al conectar: el navegador las deja
    // activas, y así la placa sigue funcionando y el USB entrega los datos.
    // (En estas placas DTR y RTS mueven los botones BOOT y RST. Ponerlas a 0
    // reiniciaba la placa, porque Windows las cambia de una en una, y con DTR
    // a 0 el conversor USB dejaba de entregar lo que llegaba.)
    port = selected; keepReading = true; buffer = ''; lastLineAt = performance.now(); lastDiagAt = 0;
    oldFirmware = false; bytesIn = 0; linesIn = 0; stale = false; uptime = null;
    text('connection', 'Conectado por USB'); $('dot').className = 'dot live';
    message('Conectado. Esperando datos de la placa...');
    setControls();
    loopDone = readLoop(selected);
  } catch (error) {
    message(error.name === 'NotFoundError' ? 'No se eligió ningún puerto.'
      : `No se pudo abrir el puerto: ${error.message}. Cierra el instalador u otros programas que lo estén usando.`);
  }
}

// Lee lo que llega por el puerto hasta que se cierre o se desenchufe.
// Tras un error puntual (ver RECOVERABLE), el navegador ofrece un flujo de
// lectura nuevo en port.readable y se sigue leyendo; el error se apunta en
// el registro para saber que se perdió algún dato.
async function readLoop(selected) {
  // TextDecoder convierte los bytes en texto (UTF-8). "stream: true" guarda
  // las letras que lleguen partidas entre dos trozos (como la ñ o las tildes).
  const decoder = new TextDecoder();
  let errors = 0;
  while (keepReading && port === selected && selected.readable) {
    reader = selected.readable.getReader();
    try {
      for (;;) {
        const { value, done } = await reader.read();
        if (done) break;
        bytesIn += value.byteLength; errors = 0;
        receive(decoder.decode(value, { stream: true }));
      }
    } catch (error) {
      addLog(`[consola] ${error.name}: ${error.message}`);
      // Un error grave, o muchos puntuales seguidos, cierran la conexión.
      if (!RECOVERABLE.has(error.name) || ++errors > 20) {
        message(`Se perdió la conexión USB: ${error.message}`); keepReading = false;
      }
    } finally {
      reader.releaseLock(); reader = null;
    }
  }
  // Si el puerto se cerró solo (cable desenchufado), se deja todo limpio.
  if (port === selected) await disconnect(true);
}

// Cierra el puerto con orden: primero se detiene la lectura y luego el puerto.
// "fromLoop" es true cuando lo llama el propio bucle de lectura (que ya ha
// terminado y no hay que esperarlo).
async function disconnect(fromLoop = false) {
  const closing = port; port = null; keepReading = false;
  if (!fromLoop) {
    try { await reader?.cancel(); } catch { /* ya estaba cerrado */ }
    try { await loopDone; } catch { /* ya había terminado */ }
  }
  try { await closing?.close(); } catch { /* ya estaba cerrado */ }
  text('connection', 'Sin conectar'); $('dot').className = 'dot';
  text('device', 'ESP32-S3 · puerto serie USB (115200)');
  setControls();
}

// Reinicia la placa como el botón RST. Con RTS activo, desactivar DTR pone
// RST a 0; al volver a activar DTR, la placa arranca normalmente (BOOT no se
// toca). Se cambia una sola línea cada vez para no pasar por combinaciones
// intermedias, y se terminan las dos activas, como al conectar.
// Al arrancar, los contadores vuelven a 0.
async function resetBoard() {
  if (!port) return;
  try {
    await port.setSignals({ requestToSend: true });
    await port.setSignals({ dataTerminalReady: false });
    await new Promise(resolve => setTimeout(resolve, 150));
    await port.setSignals({ dataTerminalReady: true });
    message('Reiniciando la placa...');
  } catch (error) { message(`No se pudo reiniciar: ${error.message}`); }
}

// ---- Texto recibido ----

// Junta los trozos que llegan y procesa cada línea completa (terminada en Enter).
function receive(chunk) {
  buffer += chunk;
  const lines = buffer.split(/\r?\n/);
  buffer = lines.pop();                       // El último trozo puede estar a medias.
  if (buffer.length > 2000) buffer = '';      // Protección ante basura sin Enter.
  for (const line of lines) handleLine(line);
}

// Procesa una línea: diagnóstico, lectura, respuesta a una orden u otro mensaje.
function handleLine(line) {
  if (!line.trim()) return;
  lastLineAt = performance.now(); linesIn++;
  // Si se estaba avisando de que no llegaban datos, se dice que han vuelto.
  if (stale) { stale = false; message('Vuelven a llegar datos de la placa.'); }
  const data = parseSerialLine(line);
  if (data?.type === 'DIAG') {
    lastDiagAt = lastLineAt;
    // "t" son los segundos que lleva encendida: si baja, se ha reiniciado.
    if (typeof data.t === 'number') {
      if (uptime !== null && data.t < uptime) addLog('[consola] La placa se ha reiniciado.');
      uptime = data.t;
    }
    renderDiag(data);
  }
  else if (data?.type === 'LECTURA') renderReading(data);
  else if (/^OK /.test(line)) message(`La placa confirmó la orden ${line.slice(3)}.`);
  else if (/^ERR /.test(line)) message(`La placa rechazó la orden: ${line}`);
  else if (/^mode=/.test(line) && !oldFirmware) {
    // Formato de las versiones 1.0.x y 1.1.0: no envían el diagnóstico por USB.
    oldFirmware = true;
    message('Esta placa tiene un firmware anterior a 1.1.1 y no envía los sensores por USB. Instala la última versión con el instalador.');
  }
  // Las líneas periódicas se pueden ocultar para que el registro se lea mejor.
  if (!(data && $('quiet').checked)) addLog(line);
}

// Ilumina un momento la tarjeta de un sensor cuando su contador sube.
function flash(id) {
  const card = $(id); card.className = 'sensor flash';
  setTimeout(() => { card.className = 'sensor'; }, 300);
}

// Muestra un diagnóstico (línea "DIAG ...").
function renderDiag(d) {
  // ---- Sensores de RPM: contador y nivel actual ----
  // Qué significa cada nivel. El infrarrojo de Sara ("Tracker Sensor") da
  // 0 V cuando NO ve nada que refleje: sobre la cinta negra del CD o sin nada
  // delante (comprobado el 20/10/2026). El Hall suele dar 0 V al detectar un imán.
  const levels = {
    ir: ['Salida a 3,3 V: ve una superficie que refleja (el CD o papel blanco).', 'Salida a 0 V: no ve nada que refleje (la cinta negra o nada delante).'],
    hall: ['Salida a 3,3 V: sin imán delante.', 'Salida a 0 V: detectando imán (su LED suele encenderse).'],
  };
  for (const [key, card] of [['ir', 'ir-card'], ['hall', 'hall-card']]) {
    const count = d[key];
    if (typeof count !== 'number') continue;
    if (counts[key] !== null && count > counts[key]) flash(card);
    counts[key] = count;
    text(`${key}-count`, count.toLocaleString('es-CO'));
    const low = d[`${key}_bajo`] === 1;
    text(`${key}-level`, levels[key][low ? 1 : 0]);
    $(`${key}-dot`).className = 'dot' + (low ? ' live' : '');
  }
  // ---- INA219: la causa más probable según lo que comprobó la placa ----
  let inaText, inaDot;
  if (d.ina) { inaText = `Encontrado en ${hex(d.ina)} y calibrado (16 V / 400 mA).`; inaDot = 'live'; }
  else if (d.bloqueo) { inaText = 'No encontrado: SDA o SCL están a 0 V. Revisa que ninguno vaya a GND.'; inaDot = 'bad'; }
  else if (!d.sda || !d.scl) {
    const missing = !d.sda && !d.scl ? 'Ni SDA (GPIO 8) ni SCL (GPIO 9) llegan' : !d.sda ? 'SDA (GPIO 8) no llega' : 'SCL (GPIO 9) no llega';
    inaText = `No encontrado: ${missing} al módulo. Revisa ese cable y que VCC vaya a 3V3 y GND a GND.`; inaDot = 'bad';
  } else { inaText = 'No encontrado, aunque SDA y SCL llegan al módulo. Comprueba que no estén intercambiados.'; inaDot = 'warn'; }
  text('ina-status', inaText); $('ina-dot').className = `dot ${inaDot}`;
  text('i2c-detail', d.i2c ? `${d.i2c} dispositivo(s) responden en I2C.` : 'Ningún dispositivo responde en SDA = GPIO 8 · SCL = GPIO 9.');
  // ---- Ajustes actuales (salvo mientras se están editando) ----
  if (document.activeElement !== $('sensor') && (d.sensor === 'IR' || d.sensor === 'HALL')) $('sensor').value = d.sensor;
  if (document.activeElement !== $('ppr') && typeof d.ppr === 'number') $('ppr').value = String(d.ppr);
}

// Muestra una lectura periódica (línea "LECTURA ...").
function renderReading(l) {
  const mode = MODES[l.mode] ?? '?';
  text('rpm-now', format(l.rpm, 0));
  const electric = l.V === null ? 'sin tensión medida' : `${format(l.V, 3)} V · ${format(l.mA, 2)} mA`;
  const origin = mode === 'DEMO' ? 'RPM simuladas' : `RPM del sensor ${l.src === 'IR' ? 'infrarrojo' : 'Hall'}${l.ppr ? `, ${l.ppr} pulso(s) por vuelta` : ' (sin PPR configurado)'}`;
  text('reading-detail', `${MODE_NAMES[mode] ?? mode} · ${origin} · ${electric} · ${STATUS_NAMES[l.status] ?? 'estado desconocido'}.`);
  $('reading-dot').className = 'dot' + (l.status === 0 ? ' live' : ' warn');
  if (document.activeElement !== $('mode') && MODES.includes(mode)) $('mode').value = mode;
}

// ---- Órdenes ----

// Envía una orden por el USB, terminada en Enter.
async function send(command) {
  if (!port?.writable) { message('Conecta antes la placa por USB.'); return; }
  const writer = port.writable.getWriter();
  try { await writer.write(new TextEncoder().encode(command + '\n')); message(`Enviada la orden ${command}. Esperando respuesta...`); }
  catch (error) { message(`No se pudo enviar: ${error.message}`); }
  finally { writer.releaseLock(); }
}

// Comprueba la orden con las mismas reglas que el monitor antes de enviarla.
function sendChecked(kind, value, help) {
  let command;
  try { command = commandText(kind, value); } catch { message(help || 'Orden no válida.'); return; }
  send(command);
}

// ---- Botones ----
$('connect').addEventListener('click', connect);
$('disconnect').addEventListener('click', () => { disconnect(); message('Puerto cerrado.'); });
$('reset').addEventListener('click', resetBoard);
$('zero').addEventListener('click', () => sendChecked('RESET', 'PULSES'));
$('sensor').addEventListener('change', () => sendChecked('SRC', $('sensor').value));
$('save-ppr').addEventListener('click', () => sendChecked('PPR', $('ppr').value, 'Pulsos por vuelta: escribe un número entero de 0 a 64.'));
$('mode').addEventListener('change', () => sendChecked('MODE', $('mode').value));
$('scan').addEventListener('click', () => sendChecked('SCAN'));
// Orden manual: en mayúsculas, sin espacios a los lados, hasta 20 caracteres.
$('send').addEventListener('click', () => {
  const command = $('command').value.trim().toUpperCase();
  if (!/^[\x20-\x7e]{1,20}$/.test(command)) { message('Escribe una orden de 1 a 20 caracteres, por ejemplo SPEED:300.'); return; }
  send(command); $('command').value = '';
});

// ---- Comprobación periódica ----
// Una vez por segundo: se actualiza el resumen de lo recibido; si hay puerto
// abierto pero no llega nada en 4 s, se avisa. Si llegan lecturas pero
// ningún diagnóstico, es un firmware antiguo.
setInterval(() => {
  if (!port) return;
  const now = performance.now();
  const ago = Math.round((now - lastLineAt) / 1000);
  text('device', `115200 baudios · ${bytesIn.toLocaleString('es-CO')} bytes · ${linesIn.toLocaleString('es-CO')} líneas · última hace ${ago} s`
    + (uptime === null ? '' : ` · placa encendida hace ${uptime} s`));
  if (now - lastLineAt > 4000) {
    stale = true;
    message(bytesIn ? 'Han dejado de llegar datos de la placa. Pulsa «Reiniciar placa» y mira los mensajes «ARRANQUE» del registro: el último indica dónde se quedó.'
      : 'No llega nada por el USB. Pulsa «Reiniciar placa» o desenchufa y vuelve a enchufar el USB.');
  } else if (!lastDiagAt && oldFirmware) message('Esta placa tiene un firmware anterior a 1.1.1 y no envía los sensores por USB. Instala la última versión con el instalador.');
}, 1000);

// Al abrir la página: Web Serial solo existe en Chrome/Edge de ordenador.
if (!('serial' in navigator)) message('Este navegador no puede usar el USB. Abre esta página en Chrome o Edge en un ordenador (no en el móvil).');
setControls();
