asturnando/generador/(commit log)

2026-08-12 Hace la portada autocontenida y enlaza Capítulo 0
2026-08-12 feat: amplia el inventario visual del capitulo 0
2026-08-12 fix: ajusta anclajes en la navegacion movil
2026-08-12 Añade el capítulo 3 sobre diseño seguro del rotor
2026-08-12 feat: añade plantillas reales del rotor sobre CD
2026-08-13 feat: completa el curso y amplia la construccion de la bobina
    [plantilla-ensayos.csv]
2026-09-29 feat: añade monitor BLE y firmware PlatformIO para bobina de 655 vueltas
2026-09-29 fix: envía la info BLE sin los bytes nulos de relleno
    NimBLE 2.x enviaba el char[200] entero, lo que rompía JSON.parse en el
    monitor (posición 92). El firmware usa ahora la longitud real y el
    monitor descarta '\0' finales para seguir funcionando con firmware antiguo.
    [main.cpp, monitor.js]
2026-09-29 fix: corta la info BLE en el primer '\0', no solo los finales
    El firmware 1.0.0 envía tras el JSON un '\0' seguido de basura de pila,
    así que quitar solo los '\0' finales no bastaba. Se añade prueba con
    ese relleno y versión al script para evitar la caché del navegador.
    [monitor.js]
2026-09-29 docs: comenta en detalle el firmware BLE y el monitor web
    Comentarios explicativos en main.cpp, protocol.h, config.h,
    platformio.ini, monitor.js y monitor-protocol.js. El código no cambia,
    salvo la versión del firmware, que pasa a 1.0.1 para distinguir la que
    envía la información sin relleno.
2026-09-29 feat: instalador web del firmware con ESP Web Tools
    instalar.html permite cargar el firmware 1.0.1 en una ESP32-S3 desde
    Chrome o Edge sin PlatformIO. Incluye la imagen combinada, su manifiesto
    y LEEME.md con los pasos para regenerarla. monitor.html se comenta, enlaza
    al instalador y sube la versión del script a v=3.
2026-10-08 feat: firmware 1.1.0 completo con diagnóstico de sensores
    Un único firmware para la placa de Sara: pines fijos (SDA 8, SCL 9,
    Hall 6, infrarrojo 7), búsqueda automática del INA219 con detección de
    cables SDA/SCL, contadores de pulsos de los dos sensores a la vez y RPM
    por tiempo entre pulsos. Sensor y pulsos por vuelta se eligen desde el
    móvil y se guardan en NVS. Nueva característica BLE de diagnóstico y
    panel "Sensores y ajustes" en el monitor, compatible con firmware
    anterior. CSV con sensor y PPR. Instalador web actualizado a 1.1.0.
2026-10-08 docs: guía de montaje completo y README del firmware 1.1.0
    montaje.html explica cada conexión de INA219, KY-003, TCRT5000, puente
    rectificador y carga, y el orden de comprobación con el monitor.
2026-10-15 docs: dibujos de cómo poner las cintas y el sensor infrarrojo
    Vista de frente y de lado a escala de un CD de 120 mm: dos cintas
    negras enfrentadas (2 pulsos por vuelta), sensor fijo a 3-5 mm y
    bobina a 10 mm, con leyenda legible en el móvil.
2026-10-20 feat: firmware 1.1.1 y consola USB para comprobar sensores sin móvil
    El firmware escribe por USB el diagnóstico ("DIAG ...") y las lecturas
    ("LECTURA ...") y acepta las mismas órdenes por el puerto serie.
    consola.html (Web Serial) muestra los contadores de pulsos, el estado
    del INA219 y la lectura actual, y permite configurar PPR, sensor y modo
    desde el ordenador al que está enchufada la placa, también por AnyDesk.
    Instalador actualizado a 1.1.1.
2026-10-20 feat: firmware 1.1.2 con diagnóstico de arranque y consola más robusta
    El firmware escribe cada paso del arranque (ARRANQUE), lleva un reloj en
    DIAG (t=), avisa si el bucle se retrasa y acorta los reintentos de
    búsqueda del INA219 a 0x40-0x4F. La consola USB usa un búfer mayor,
    sigue leyendo tras errores puntuales del puerto, muestra bytes, líneas y
    tiempo desde la última línea, y avisa cuando la placa se reinicia.
2026-10-20 fix: la consola USB no toca DTR/RTS al conectar
    Ponerlas a 0 reiniciaba la placa (Windows las cambia una a una y el
    estado intermedio activa RST) y, con DTR a 0, el conversor USB dejaba de
    entregar datos. Ahora se dejan como las pone el navegador, igual que la
    consola de ESP Web Tools, y el reinicio cambia una sola línea cada vez.
2026-10-20 fix: textos del nivel de los sensores según el módulo real de Sara
    El infrarrojo "Tracker Sensor" da 0 V cuando no ve nada que refleje
    (cinta negra o nada delante) y 3,3 V sobre el CD o papel blanco,
    comprobado con la consola USB. Monitor y consola lo describen así.
2026-10-23 feat: modo teórico en el monitor (ley de Faraday con RPM medidas)
    Nueva opción «Teórico» en el origen de los datos: la placa trabaja en
    mixto (RPM medidas por el sensor) y el monitor calcula tensión,
    corriente y potencia con un modelo de Faraday para una bobina bien
    colocada (imanes de 15 × 2 mm, distancia y número de imanes ajustables,
    carga de 100 Ω y puente). Se rotula siempre como teórico, también en el
    CSV (origen TEORICO). No cambia el firmware.
